liyue75/pcb/AX615D_DEMO_V1.3_SVN/AX615D_DEMO_V1_3_BOM.xlsx

项目 | AX615D_DEMO_V1_3
日期 | 2026-06-09
设计 | xieyibei@axera-tech.com
审核
序号 | 物料描述 | 数量 | 位号 | 供应商 | 供应商料号 | 加工方式 | 备注
1 | CAP CER 1uF 10% 10V 0402 X5R | 55 | C3,C6,C12,C15,C16,C29,C36,C41,C42,C53,C54,C71,C72,C79,C80,C87,C89,C91,C92,C97,C99,C106,C107,C110,C111,C112,C114,C116,C120,C121,C123,C129,C130,C135,C140,C143,C144,C146,C148,C149,C152,C153,C154,C155,C158,C159,C260,C261,C264,C269,C580,C590,C591,C640,C642 |  |  | SMT
2 | CAP CER 18pF 5% 50V 0402 C0G | 4 | C4,C7,C9,C11 |  |  | SMT
3 | CAP CER 12pF 5% 50V 0402 C0G | 2 | C5,C8 |  |  | SMT
4 | CAP CER 100nF 10% 16V 0402 X7R | 47 | C13,C14,C19,C24,C25,C30,C31,C32,C34,C43,C45,C55,C57,C68,C70,C73,C75,C78,C82,C84,C100,C101,C103,C108,C113,C119,C126,C134,C138,C161,C162,C163,C164,C165,C166,C168,C170,C194,C218,C219,C244,C252,C256,C262,C440,C567,C607 |  |  | SMT
5 | CAP CER 2.2uF 10% 6.3V 0402 X5R | 15 | C18,C21,C28,C33,C35,C167,C169,C182,C502,C503,C557,C623,C624,C628,C629 |  |  | SMT
6 | CAP CER 10uF 20% 10V 0603 X7R | 25 | C40,C44,C46,C67,C69,C74,C77,C81,C83,C85,C86,C109,C115,C131,C132,C133,C139,C160,C253,C254,C255,C263,C415,C581,C641 |  |  | SMT
7 | CAP CER 10nF 10% 50V 0402 X7R | 10 | C50,C51,C56,C58,C136,C137,C150,C151,C156,C157 |  |  | SMT
8 | CAP CER 1uF 10% 25V 0402 X7R | 8 | C59,C60,C61,C62,C63,C64,C65,C66 |  |  | SMT
9 | CAP CER 4.7uF 20% 6.3V 0402 X5R | 1 | C76 |  |  | SMT
10 | CAP CER 33pF 5% 50V 0402 C0G | 4 | C93,C94,C95,C96 |  |  | SMT
11 | CAP CER 100uF 20% 10V 1210 X5R | 1 | C98 |  |  | SMT
12 | CAP CER 22uF 20% 10V 0603 X5R | 40 | C117,C118,C122,C124,C141,C142,C177,C178,C179,C184,C185,C188,C191,C200,C202,C203,C204,C212,C214,C215,C216,C217,C225,C228,C229,C230,C242,C245,C246,C247,C248,C563,C564,C592,C594,C596,C598,C600,C602,C603 |  |  | SMT
13 | CAP CER 220nF 10% 10V 0402 X7R | 3 | C145,C147,C210 |  |  | SMT
14 | CAP CER 100nF 10% 50V 0402 X5R | 5 | C171,C172,C175,C176,C181 |  |  | SMT
15 | CAP CER 22uF 20% 25V 0805 X5R | 3 | C173,C174,C251 |  |  | SMT
16 | CAP CER 2nF 10% 50V 0402 X7R | 1 | C180 |  |  | SMT
17 | CAP CER 100pF 5% 50V 0402 C0G | 4 | C183,C192,C227,C234 |  |  | SMT
18 | CAP CER 22pF 5% 50V 0402 C0G | 1 | C201 |  |  | SMT
19 | CAP CER 220pF 10% 50V 0402 X7R | 3 | C213,C243,C605 |  |  | SMT
20 | CAP CER 22nF 10% 50V 0402 X7R | 2 | C235,C265 |  |  | SMT
21 | CAP CER 47nF 10% 50V 0402 X7R | 2 | C249,C601 |  |  | SMT
22 | CAP CER 10uF 20% 25V 0603 X5R | 2 | C266,C267 |  |  | SMT
23 | CAP CER 1uF 20% 6.3V 0201 X5R | 12 | C559,C560,C561,C613,C614,C615,C616,C617,C618,C619,C625,C626 |  |  | SMT
24 | CAP CER 1000pF 10% 2KV 1206 X7R | 1 | C562 |  |  | SMT
25 | CAP CER 10pF 5% 50V 0402 C0G | 6 | C573,C574,C575,C576,C593,C597 |  |  | SMT
26 | Schottky, Vr 30V, If 0.2A, SOD-523 | 1 | D1 | ONSemi | RB520S30T1G | SMT
27 | TVS Bidirection 5V 300W SOD-523 | 7 | D3,D4,D19,D20,D21,D22,D34 | WAYON | WS05D5-B | SMT
28 | TVS Bidirection 5V 310W SOD-323 | 8 | D5,D6,D7,D8,D9,D10,D11,D13 | WAYON | WS05DLC-B | SMT
29 | TVS 135W 5V 2.5pF SOT-143 | 2 | D12,D29 | WAYON | WS05RXLC | SMT
30 | TVS Bidirection 3.3V 320W SOD-323 | 6 | D16,D17,D35,D36,D37,D38 | WAYON | WS03DLC-B | SMT
31 | TVS Bidirection 6.5V 600W SMB | 6 | D23,D24,D25,D26,D27,D28 | WAYON | WS6.5P6SMB-B | SMT
32 | TVS Bidirection, 3000W, 15V, SMC | 1 | D30 | WAYON | WS15P30SMC-B | SMT
33 | LED 0603, Brilliant Red | 1 | D31 | EverLight | 19-217/R6C-AL1M2VY/3T | SMT
34 | Gas discharge tube, 8/20us 5KA, 90V, 5x5mm | 1 | D33 | RUILON | SMD5050-090NA | SMT
35 | Ferrite Bead, 450mA, DCR 340mohm, 600ohm at 100MHz, 0402 | 2 | FB3,FB4 | Sunlord | PZ1005U601-R45TF | SMT
36 | Ferrite Bead, 2A, DCR 80mohm, 220ohm at 100MHz, 01206 | 10 | FB6,FB7,FB8,FB12,FB13,FB14,FB15,FB20,FB21,FB22 | Sunlord | PZ3216U221-2R0TF | SMT
37 | Ferrite Bead, 600mA, DCR 180mohm, 220ohm at 100MHz, 0402 | 2 | FB9,FB10 | Sunlord | PZ1005E221-R60TF | SMT
38 | Ferrite Bead, 3A, DCR 30mohm, 30ohm at 100MHz, 0603 | 4 | FB16,FB17,FB18,FB19 | Sunlord | PZ1608D300-3R0TF | SMT
39 | WAFER, 1.25mm, 5pin, 1.0A | 1 | J1 | TXGA | FWF12505-S05S24W5M | SMT
40 | Screw Header 2x1 Pin, Pitch 3.81mm | 5 | J2,J16,J19,J20,J32 | DEGSON | DG380-3.81-02P-14 | DIP
41 | TF Card Socket TF-01A | 1 | J3 | HRO | TF-01A | SMT
42 | Header 3P Pitch 2.54mm | 4 | J5,J8,J23,J29 |  |  | DIP
43 | Micro USB Female 5P SMT | 2 | J6,J21 | Dongguan VAST | C-103012662-00 | SMT
44 | RJ45 DIP TYPE WITH 2 LEDs | 1 | J7 | Dongguan VAST | C-120010911-00 | DIP
45 | FFC/FPC Connector,0.5mm,V-Flip,4.05mm,50Circuits | 3 | J9,J10,J11 | MOLEX | 5019515010 | SMT
46 | FPC , 50P, Pitch 0.5mm, Bottom Contact | 2 | J12,J30 | GYUEDA | FPC50_T1T1_2020_A | SMT
47 | FFC/FPC Connector,0.5mm,V-Flip,4.05mm,40Circuits | 2 | J13,J25 | MOLEX | 501951-4010 | SMT
48 | WAFER, 1.25mm, 2pin, 1.0A | 2 | J14,J15 | TXGA | FWF12505-S02S24W5M | SMT
49 | 3.5mm SMD Headphone Holder | 2 | J17,J18 | XKB | PJ-327A0-SMT | SMT
50 | Header, 2P, Pitch 2.54mm, XH2.54-2P | 1 | J24 |  | XH2.54-2P | DIP
51 | DC JACK, 5.5mm, 30V, 3A ,hole 2.0 | 1 | J26 | XUNPU | DC-005-A200 | DIP
52 | Header 8P Pitch 2.54mm | 1 | J28 |  |  | DIP
53 | IND WIRE 1uH 20% Irms=8.5A Isat=10A 14mOhm | 1 | L3 | Sunlord | MWSA0503S-1R0MT | SMT
54 | IND WIRE 2.2uH 20% Irms=1.7A,Isat=2.15A 142mohm, 2.0x1.6x1.0mm | 6 | L4,L5,L6,L10,L11,L14 | Sunlord | WPN201610H2R2MT | SMT
55 | IND 0.47uH 20% 3.7A 38mOhm | 4 | L8,L12,L16,L17 | Sunlord | WPN252010HR47MT | SMT
56 | IND Wire Wound 2.2uH 20% 2.4A 80mOhm | 1 | L13 | Sunlord | WPN252010U2R2MT | SMT
57 | IND WIRE 1.0uH 20% Irms=6.0A Isat=7A 27mOhm | 1 | L18 | Sunlord | MWSA0402S-1R0MT | SMT
58 | PMOS, Vds -20V, Id -4.3A, SOT23-3 | 2 | Q1,Q6 | Will | WPM2341-3/TR | SMT
59 | NPN Transistor, Ic 200mA, Vce 40V,SOT23-3 | 2 | Q2,Q7 | NEXPERIA | PMBT3904 | SMT
60 | NMOS, Vds 20V, Id 0.90A, SOT-23 | 2 | Q3,Q5 | Will | WNM2020-3/TR | SMT
61 | PTC 16V 5A 2.6W DIP | 1 | RV1 | WAYON | LP16-500F | DIP
62 | RES 0R 1% 0402 | 201 | R1,R2,R4,R19,R27,R35,R36,R40,R60,R62,R63,R64,R66,R67,R68,R73,R95,R97,R98,R105,R106,R114,R115,R116,R117,R121,R122,R127,R131,R132,R137,R138,R141,R143,R144,R147,R148,R151,R152,R155,R156,R159,R160,R163,R164,R167,R168,R169,R170,R171,R172,R176,R177,R179,R180,R181,R182,R183,R184,R185,R188,R192,R194,R197,R198,R199,R200,R201,R202,R209,R210,R212,R214,R215,R217,R219,R221,R223,R224,R225,R227,R228,R229,R230,R232,R234,R237,R239,R240,R241,R242,R245,R246,R247,R251,R252,R254,R255,R256,R267,R271,R273,R274,R278,R279,R280,R281,R283,R285,R286,R287,R291,R293,R296,R297,R298,R299,R300,R301,R303,R304,R305,R306,R309,R310,R311,R335,R341,R342,R432,R464,R465,R466,R467,R468,R469,R470,R471,R475,R476,R483,R484,R485,R486,R487,R489,R669,R671,R693,R695,R700,R702,R704,R706,R709,R711,R717,R724,R729,R733,R738,R748,R755,R756,R766,R767,R768,R769,R770,R775,R780,R782,R784,R807,R808,R810,R812,R822,R823,R825,R826,R828,R831,R832,R834,R835,R844,R845,R846,R847,R848,R849,R850,R851,R852,R853,R854,R855,R857,R858,R859 |  |  | SMT
63 | RES 1.4K 1% 0402 | 1 | R5 |  |  | SMT
64 | RES 47K 1% 0402 | 8 | R7,R8,R10,R11,R30,R289,R346,R690 |  |  | SMT
65 | RES 100R 1% 0402 | 3 | R9,R779,R836 |  |  | SMT
66 | RES 200R 1% 0402 | 1 | R14 |  |  | SMT
67 | RES 620R 1% 0402 | 1 | R16 |  |  | SMT
68 | RES 1M 1% 0402 | 1 | R18 |  |  | SMT
69 | RES 1.5K 1% 0402 | 6 | R21,R22,R23,R24,R672,R673 |  |  | SMT
70 | RES 1K 1% 0402 | 7 | R28,R33,R34,R100,R350,R759,R806 |  |  | SMT
71 | RES 4.7K 1% 0402 | 31 | R29,R31,R32,R41,R59,R69,R70,R71,R101,R203,R204,R205,R206,R207,R208,R250,R321,R322,R327,R328,R337,R338,R339,R344,R349,R353,R424,R426,R430,R758,R833 |  |  | SMT
72 | RES 10K 1% 0402 | 29 | R43,R93,R94,R268,R269,R307,R308,R312,R313,R314,R343,R345,R352,R385,R410,R421,R453,R454,R455,R456,R457,R458,R459,R460,R461,R462,R607,R663,R698 |  |  | SMT
73 | RES 100K 1% 0402 | 25 | R99,R288,R290,R295,R347,R362,R363,R364,R365,R383,R399,R400,R402,R403,R415,R661,R677,R786,R787,R789,R790,R797,R799,R837,R838 |  |  | SMT
74 | RES 470R 1% 0402 | 4 | R102,R109,R112,R778 |  |  | SMT
75 | RES 2.2R 1% 0402 | 4 | R104,R107,R108,R110 |  |  | SMT
76 | RES 0R 1% 1206 | 1 | R113 |  |  | SMT
77 | RES 33R 1% 0402 | 1 | R248 |  |  | SMT
78 | RES 1.1K 1% 0402 | 8 | R257,R258,R259,R260,R263,R264,R265,R266 |  |  | SMT
79 | RES 0R 1% 0603 | 5 | R275,R282,R355,R393,R680 |  |  | SMT
80 | RES 20K 1% 0402 | 6 | R315,R316,R317,R318,R388,R412 |  |  | SMT
81 | RES 2K 1% 0402 | 5 | R319,R323,R325,R329,R428 |  |  | SMT
82 | RES 30K 1% 0402 | 7 | R320,R324,R326,R330,R382,R407,R839 |  |  | SMT
83 | RES 5mOhm 1% 2W 2512 | 8 | R348,R359,R360,R372,R380,R395,R396,R408 | YAGEO | PA2512FKF7W0R005E | SMT
84 | RES 40.2K 1% 0402 | 4 | R351,R381,R414,R804 |  |  | SMT
85 | RES 5.49K 1% 0402 | 1 | R354 |  |  | SMT
86 | RES 200K 1% 0402 | 3 | R361,R397,R792 |  |  | SMT
87 | RES 22.1K 1% 0402 | 2 | R366,R404 |  |  | SMT
88 | RES 80.6K 1% 0402 | 5 | R374,R378,R387,R416,R805 |  |  | SMT
89 | RES 150K 1% 0402 | 2 | R375,R423 |  |  | SMT
90 | RES 240K 1% 0402 | 2 | R384,R409 |  |  | SMT
91 | RES 75K 1% 0402 | 1 | R425 |  |  | SMT
92 | RES 511R 1% 0402 | 1 | R429 |  |  | SMT
93 | RES 0R 1% 0805 | 3 | R473,R772,R781 |  |  | SMT
94 | RES 75R 1% 1206 | 2 | R490,R668 |  |  | SMT
95 | RES 22R 1% 0402 | 2 | R776,R777 |  |  | SMT
96 | RES 300K 1% 0402 | 1 | R788 |  |  | SMT
97 | RES 82K 1% 0402 | 2 | R791,R793 |  |  | SMT
98 | Push Button 4PIN 4.5x4.5x3.8mm SMT | 3 | SW2,SW3,SW4 | HRO | K2-1109SP | SMT
99 | Switch, 2 Way, Pitch 1.27mm, SMT | 5 | S1,S2,S3,S7,S12 | HRO | EP-02KS | SMT
100 | Switch, 4 Way, Pitch 1.27mm, SMT | 4 | S4,S9,S10,S11 | HRO | EP-04KS | SMT
101 | Switch, 8 Way, Pitch 1.27mm, SMT | 5 | S5,S6,S8,S13,S14 | HRO | EP-08KS | SMT
102 | Transformer 10/100 Base-T,Surface Mount Type,H1601CG, 0~70??, | 1 | T1 | Mentech | H1601CG | SMT
103 | AX615D | 1 | U1 | AXERA | AX615D | SMT
104 | Lithium Rechargeable Battery, 6.8x2.1mm, 3V, 5.5mAh | 1 | U2 | SII | MS621FE-FL11E | Hand
105 | IC low power RTC chip with I2C, 1.3~5.5V, MSOP8 3x3mm H1.1mm | 1 | U3 | AnalogTek | AT8563S | SMT
106 | IC 2-Bit Bidirectional Voltage-Level Translator SOT23_8 2.91x1.6mm H1.25mm | 2 | U4,U23 | SGMICRO | SGM4553YN8G/TR | SMT
107 | IC SPI NOR Flash 128Mb 3.3V WSON8 | 1 | U6 | Winbond | W25Q128JVEIQ | SMT
108 | IC EMMC 8GB 2.7~3.6V 5nS SMD BGA153 | 1 | U7 | Samsung | KLM8G1GETF-B041 | SMT
109 | IC Power Switch, 2.5~5.5V, 2A, SOT23-6 | 1 | U8 | Silergy | SY6287CABC | SMT
110 | Three-Channel High-Speed MIPI Switch,2.5GHz | 2 | U9,U10 | WILL | WAS4642Q-24/TR | SMT
111 | MEMS microphone Analog output,1.6V~3.6V,Sensitvity -32dBv | 4 | U11,U12,U19,U20 | Will Semi | WMM7037ATTS7 | SMT
112 | MEMS microphone, PDM digital output,1.62~3.6V | 1 | U13 | MEMSensing | WMM7035DBUJ0-5/TR | SMT
113 | Class-D Audio Power Amplifier 3W | 1 | U14 | SGMICRO | SGM2820YMS8G/TR | SMT
114 | Stereo Audio ADC,101 dB SNR,24-bit, 8 to 96 kHz sampling frequency | 1 | U15 | Everest | ES7243L | SMT
115 | IC LDO 500mA, Vin 2.5~5.5V, Vout 1.8V, SOT23-5 | 1 | U16 | Will Semi | WL2803E18-5/TR | SMT
116 | Stereo Audio DAC,110 dB SNR,24-bit, 8 to 96 kHz sampling frequency,QFN20 | 1 | U17 | Everest | ES8156 | SMT
117 | LDO 500mA, Vin 2.5~5.5V, Vout 3.3V, SOT23-5 | 2 | U18,U37 | Will Semi | WL2803E33-5/TR | SMT
118 | Stereo Audio Power Amplifier 2.6W SGM4865 | 1 | U21 | SGMICRO | SGM4865YTQE16G/TR | SMT
119 | IC USB to UART, 2.97~5.5V, IO 1.62~3.63V, DFN-12 3x3mm 0.8mm | 1 | U22 | FTDI | FT234XD-R | SMT
120 | IC Buck 6A, 4~28V, 800KHz, QFN-12, 3x3mm, H=0.75mm | 1 | U24 | Silergy | SY8366AQQC | SMT
121 | IC BUCK, 1.5A, 2.6-7V, 2MHZ, SOT23_5, 2.95x1.7mm, H=1.25mm | 4 | U25,U26,U28,U30 | ETA | ETA3485S2F | SMT
122 | IC BUCK, 1A, 2.5-5.5V, 1.5MHZ, SOT23_5, 2.96x1.6mm, H=1.2mm | 2 | U32,U33 | Silergy | SY8088IAAC | SMT
123 | IC BUCK, COT,3A, 2.5-5.5V, 2MHZ, SOT23_5,2.92x1.6mm,H=1.15mm | 1 | U35 | ETA | ETA3448S2F | SMT
124 | IC Buck,600mA,1.8~5.5V,3.5MHZ, WLCSP-0.9X1.3-6B-A, 0.9x1.3mm, H=0.545mm | 2 | U41,U42 | SGMICRO | SGM61006XG/TR | SMT
125 | IC Buck,COT, 4A, 2.5~5.5V, Force PWM Mode, QFN-12,3x2mm,H=0.55mm | 1 | U43 | ETA | ETA3147WFQ7M | SMT
126 | IC AUDIO AMP, I2S/TDM input, 10.25V BOOST Digital Smart K PA Converter | 1 | U44 | AWINIC | AW88261FCR | SMT
127 | Crystal 32.768kHz, +-20ppm, -40~85C, 12.5pF, 3215 | 2 | X1,X3 | TXC | 9H03200031 | SMT
128 | Crystal 24MHz, 10ppm, -40~85C, 8pF, 2016 | 1 | X2 | TXC | 8Y24000042 | SMT
