liyue75/pcb/AX615D_DEMO_V1.3_SVN/AX615_AVL_V1.1.xlsx

Sheet: 质量声明
SecondSource AVL质量声明：
由于用到验证的器件（包括但不限于：Flash、Sensor、DDR等）数量有限以及验证时间受限，仅能保证AVL中提到的器件型号在爱芯对应芯片平台上做过基本功能的适配，并不能确保该器件在批量量产中发生的质量问题。器件本身的一致性和质量问题请同器件厂家沟通。 爱芯元智半导体股份有限公司

Sheet: 修订记录
日期DATE | 文档版本号 | 修改记录Revised Description
2025-10-29 | V1.0 | Initial
2026-09-30 | V1.1 | Add DDR list for AX615E

Sheet: FLASH
类型 | 厂家物料编码 | 厂家 | 工作电压 | 容量 | 擦写寿命 | 温度等级 | 测试温度
NAND | W25N02KVZEIR | WINBOND | 3.3V | 2Gbit | 6w次 | (-40~85℃) | (-40~70℃)
NAND | GD5F1GM7UEYIGY | GIGADEVICE | 3.3V | 1Gbit | 5w次 | (-40~85℃) | (-40~70℃)
NAND | F35SQA001G-WWT | foresee | 3.3V | 1Gbit | 10W次 | (-40~85℃) | (-40~70℃)
NAND | FM25LS01 | fmsh | 1.8V | 1Gbit | 10W次 | (-40~85℃) | (-40~70℃)
NOR | W25Q128JVEIQ | WINBOND | 3.3V | 128Mbit | 10w次 | (-40~125℃) | (-40~70℃)

Sheet: DDR
 | Platform Info/平台信息 |  |  | Device Info/器件信息
序号 | 平台 | 测试频率 | 测试温度 | 厂家物料编码 | 厂家 | 类型 | 容量 | 频率 | 温度等级
1 | AX615E | 1866Mbps | (-40~70℃) | W632GU6RB11k | Winbond | DDR3L | 2Gb | 1866Mbps | –40°C to +105°C

Sheet: DCDC
电源 | P/N | Vendor | Current | Input Voltage | Reference Voltage | Switdching Frequency | Operating Junction Temp | Package | 备注
VDDCORE | ETA3448S2F | ETA | 3A | 2.5V to 5.5V | 0.6V | 2MHz | -40°C to +85°C | SOT23-5
 | ETA3147WFQ7M | ETA | 4A | 2.5V to 5.5V | 0.6V | 1MHz | -40°C to +85°C | QFN2x3-12
AON_VDDCORE | ETA3485S2F | ETA | 1.5A | 2.6V to 7V | 0.6V | 2MHz | -40°C to +85°C | SOT23-5
 | SGM61006XG/TR | SGM | 0.6A | 4.5V to 17V | 0.6V | 3.5MHz | -40°C to +85°C | WLCSP-0.9×1.3-6B-A
