liyue75/pcb/SENSOR_SC438HAI_V1_0_Assembly.pdf

# ART FILM - ASSEMBLY_TOP

5V

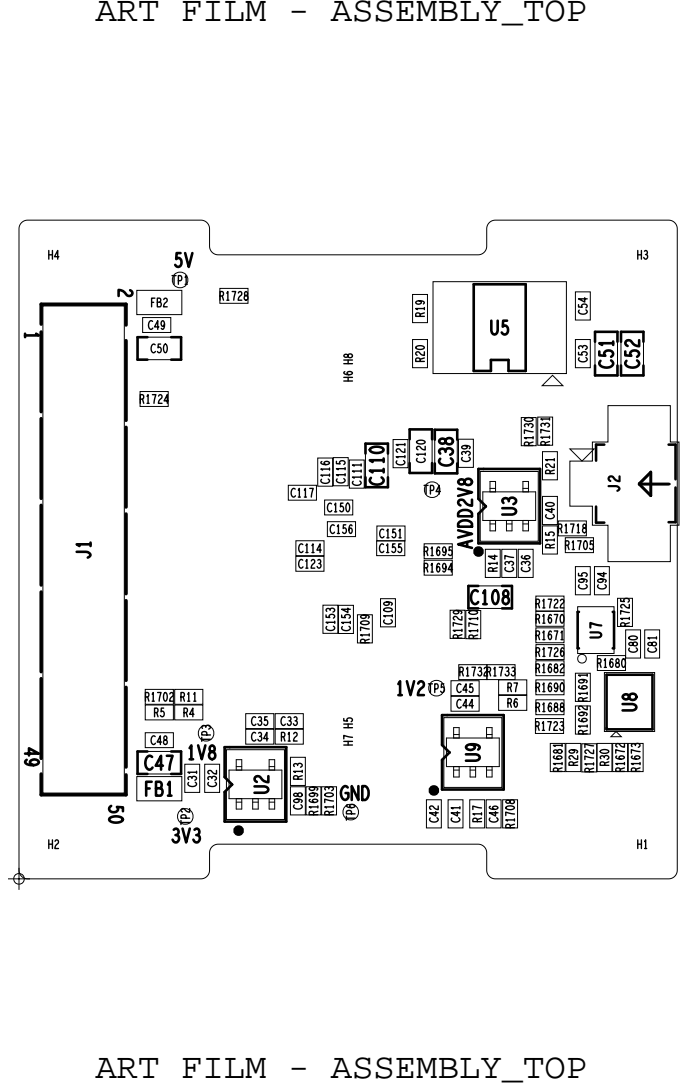
[picture p1: page 1]

# ART FILM - ASSEMBLY_BOT

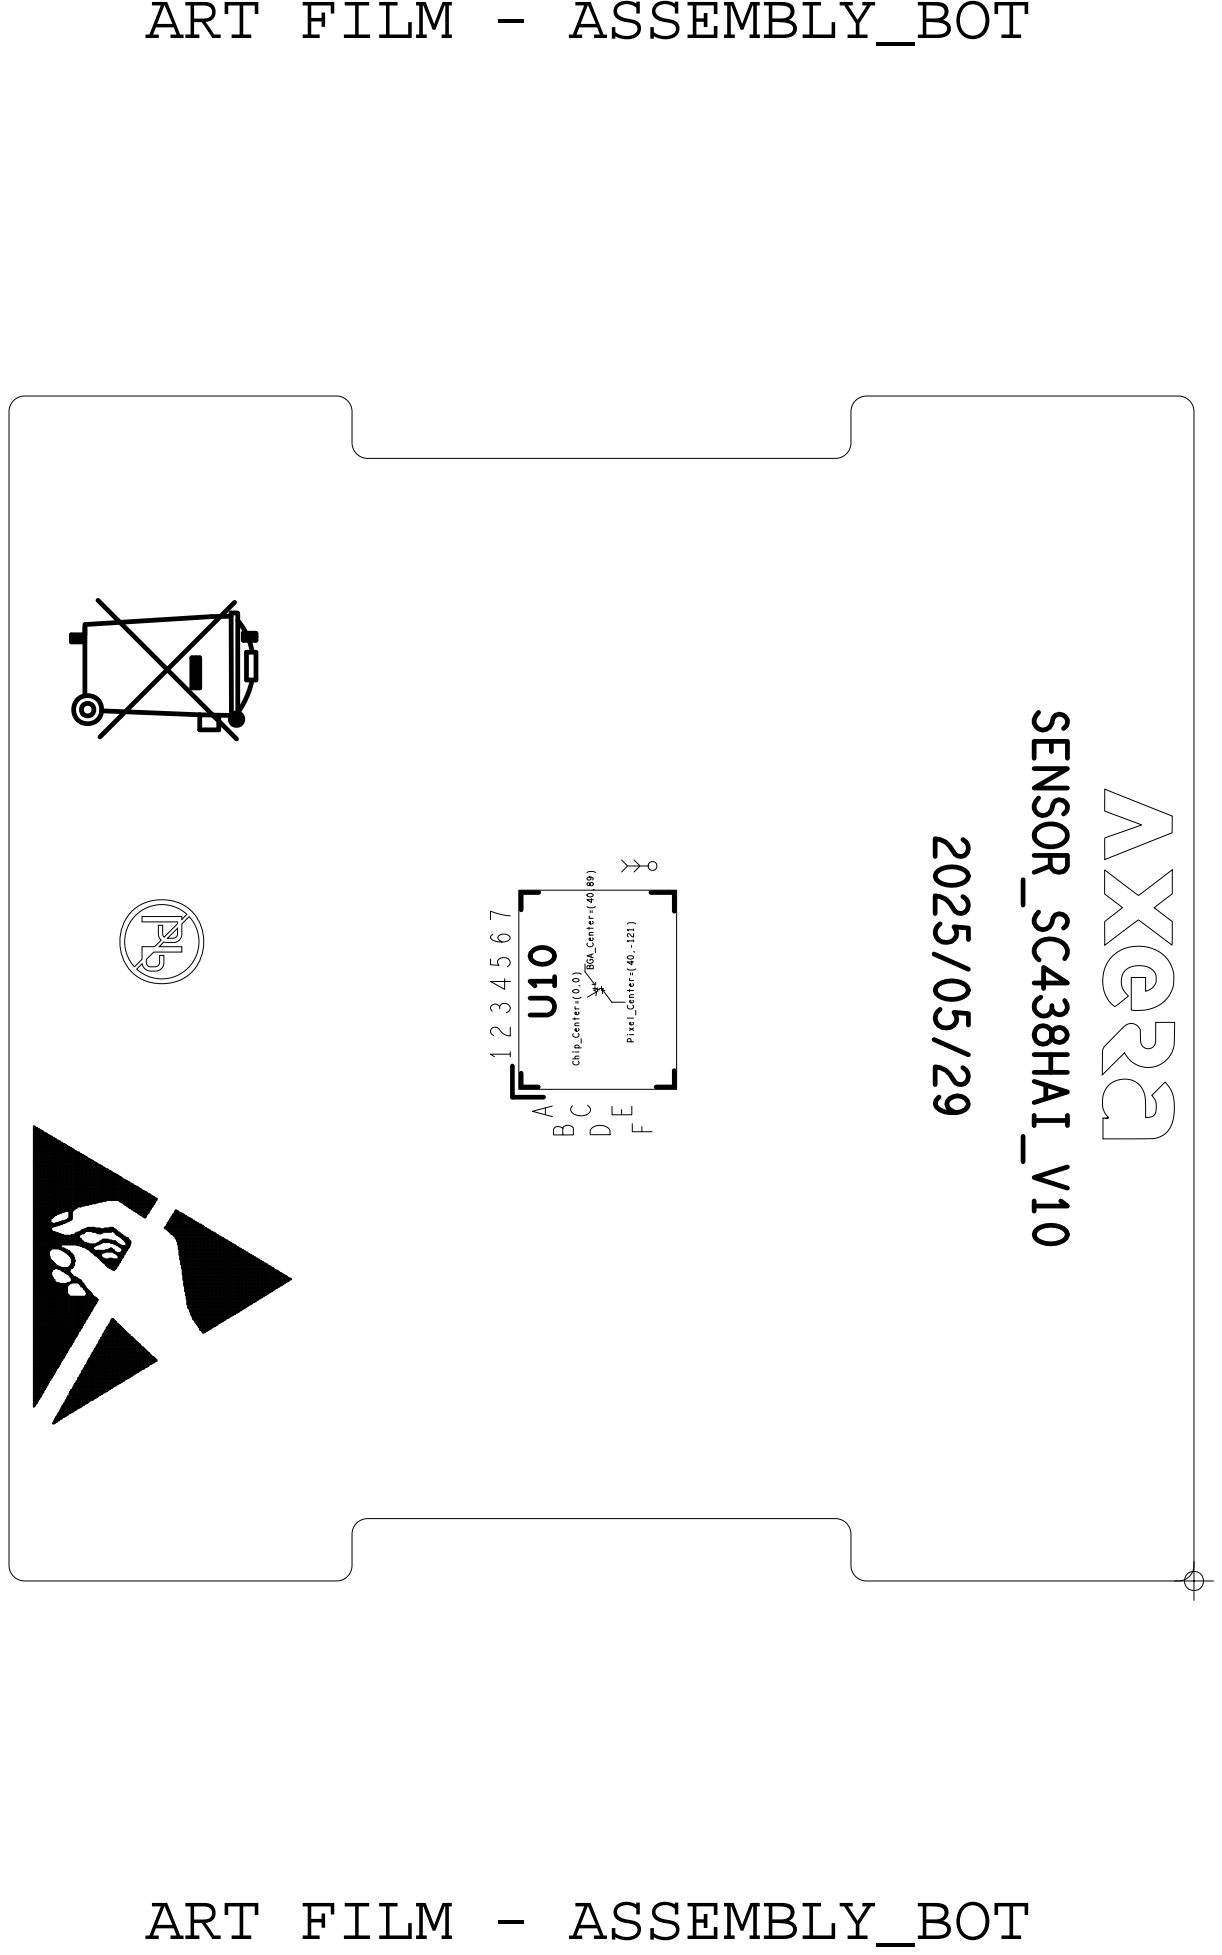
[picture p2: page 2]
ART FILM - ASSEMBLY_BOT; BGA_Center=(40,89); Chip_Center=(0,0) B; Pixel_Center=(40,-121); SENSOR_SC438HAI_V10
