liyue75/pcb/SENSOR_SC438HAI_V1_0.pdf

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
# SENSOR_SC438HAI VER 1.0

# P01.Revision History P02.Sensor P03.Power P04.Cononector

# P00.Cover

# P05.IR-CUT

# Create Project

# Date Author

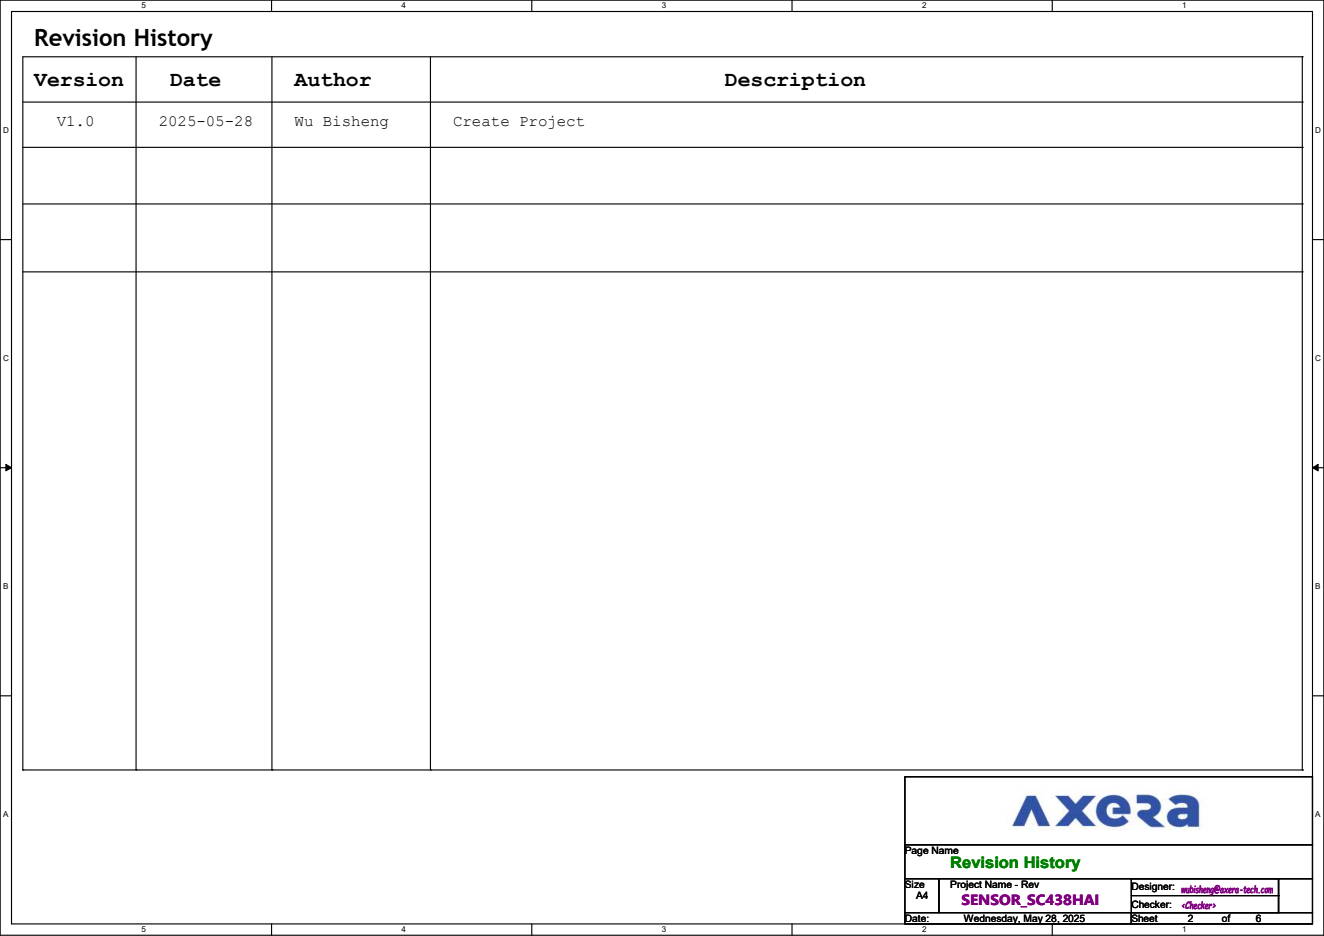
[picture p3: page 2]
Revision History; Description; Version; Wu Bisheng; Page Name; Size; Project Name - Rev; Date:; Sheet; Designer:; SENSOR_SC438HAI; Checker:; Wednesday, May 28, 2025

wubisheng@axera-tech.com
<Checker>

# 100nF/16V C156

# 4.7uF/6.3V C123

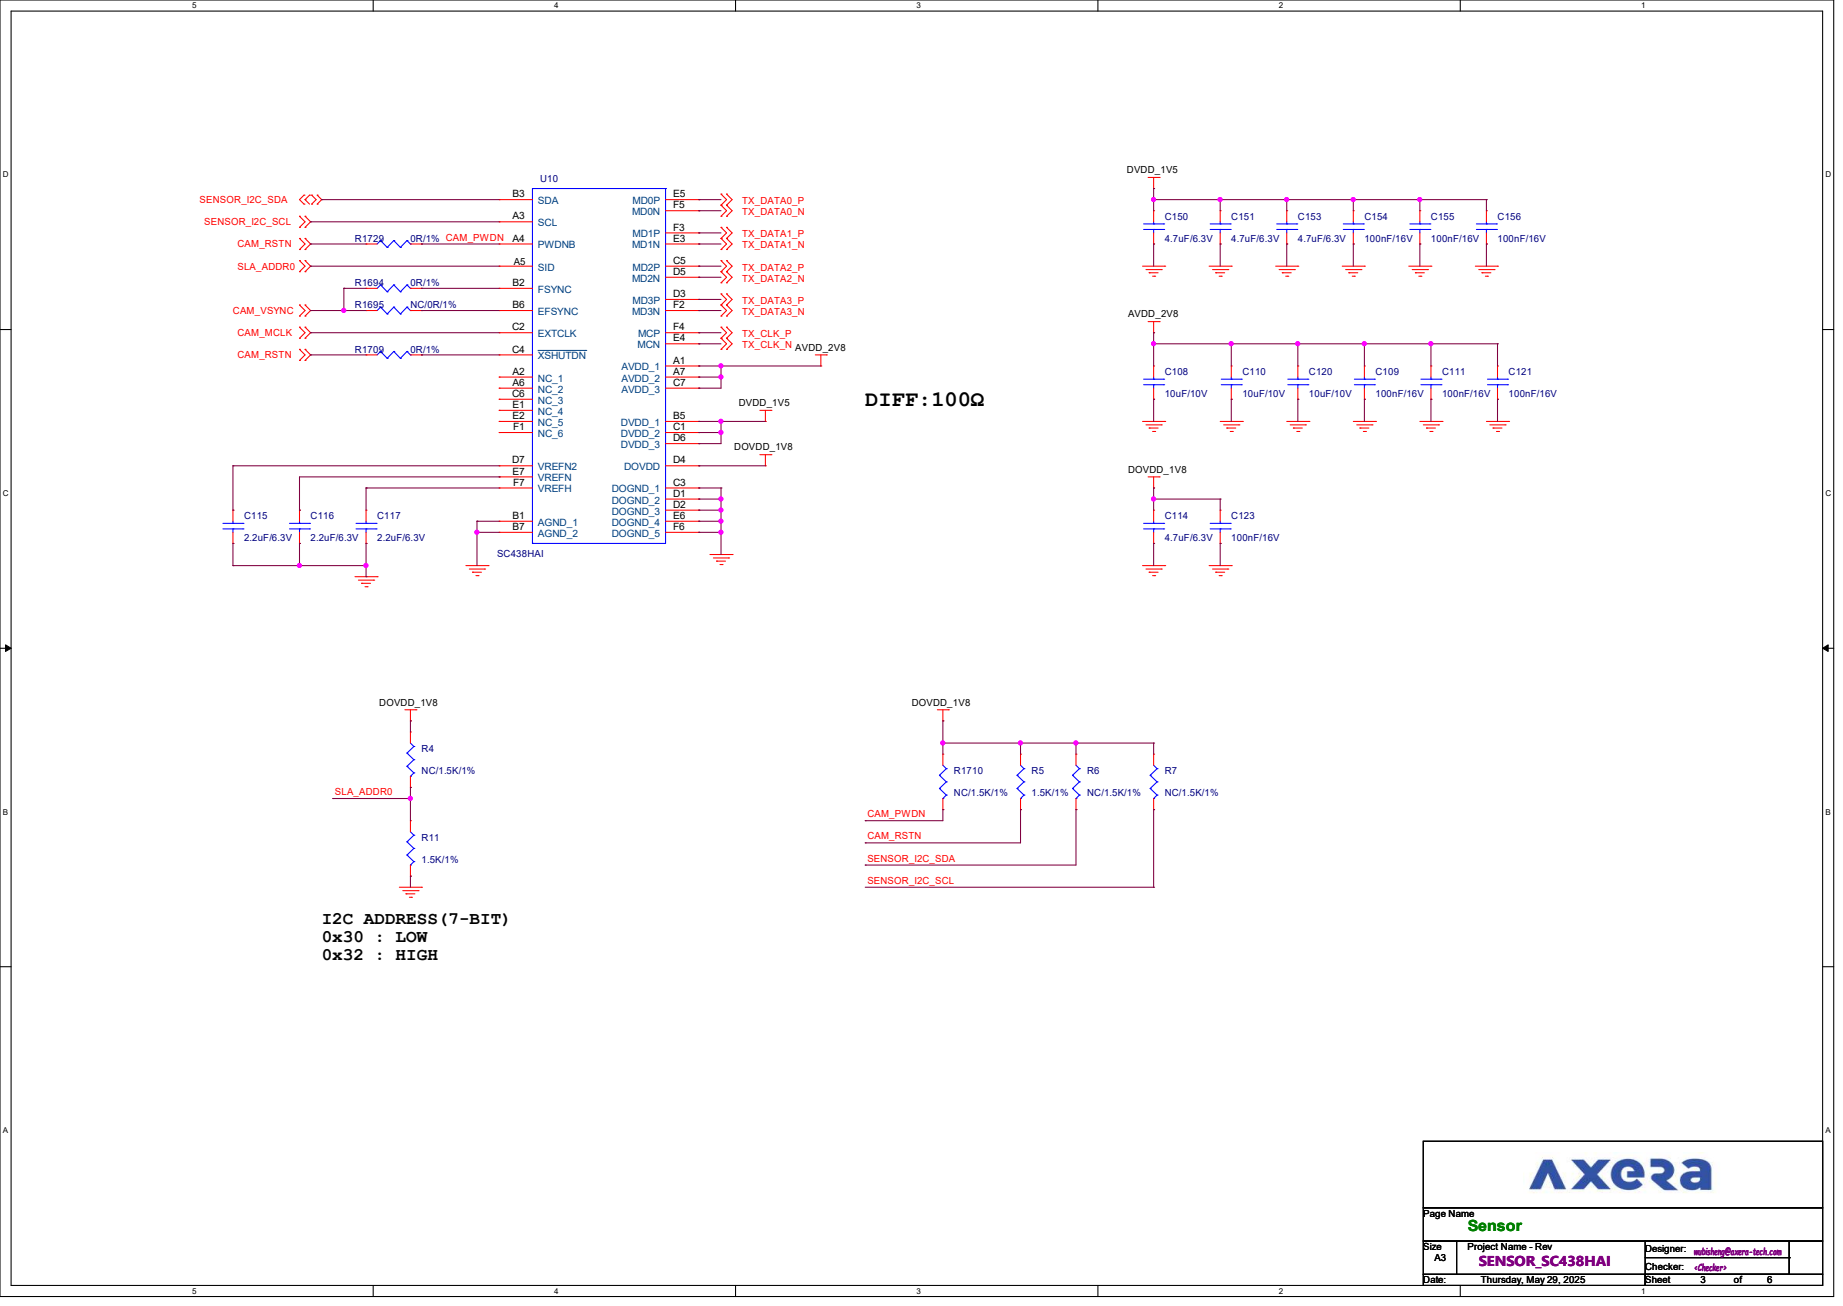
[picture p4: page 3]

DVDD_3V3 | DOVDD_1V8

R12

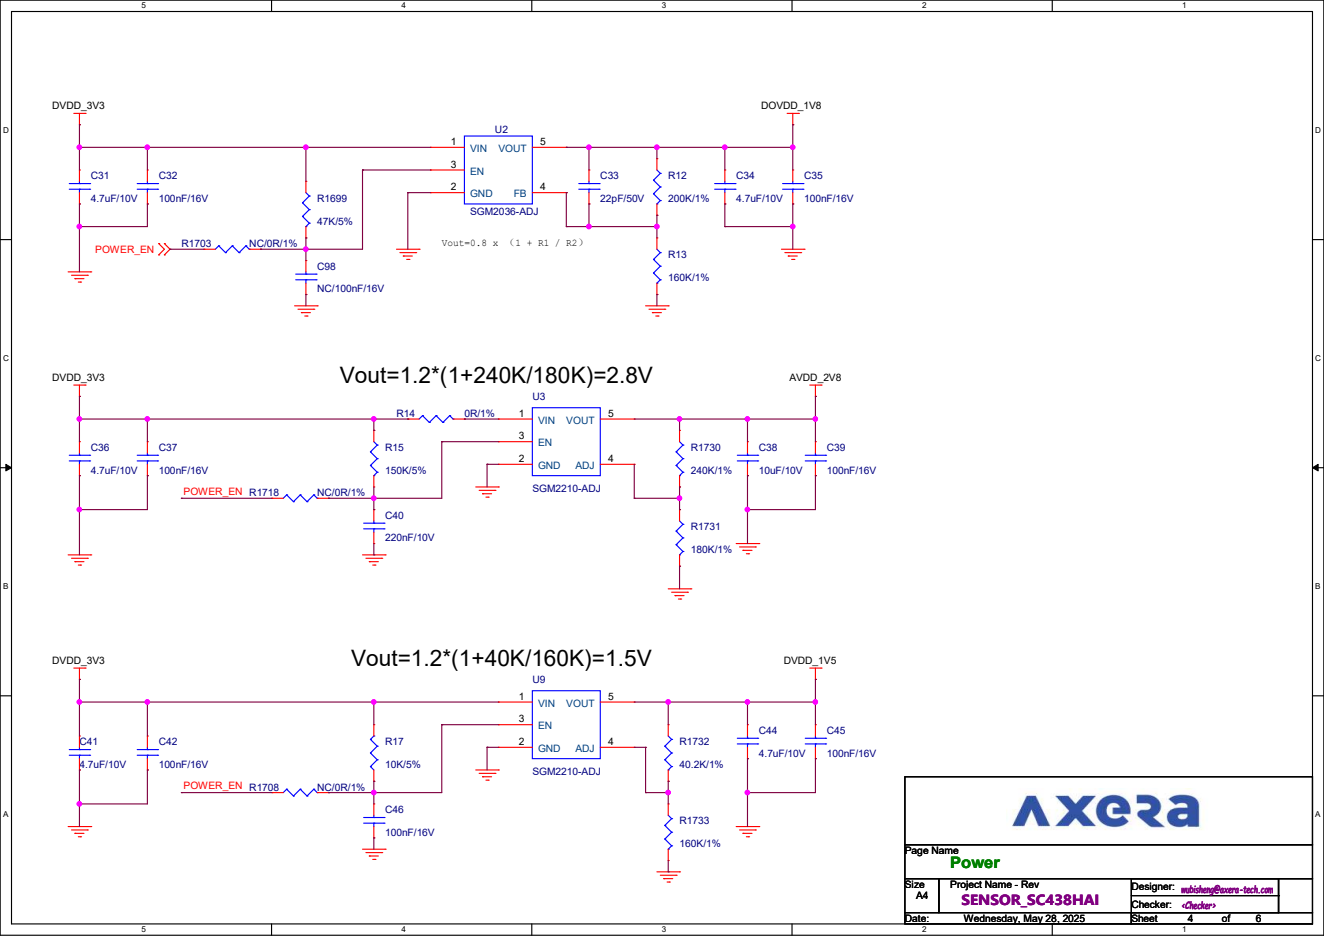
[picture p5: page 4]

wubisheng@axera-tech.com

Contact Side J1 | VSS BO¹ | VSS BO²

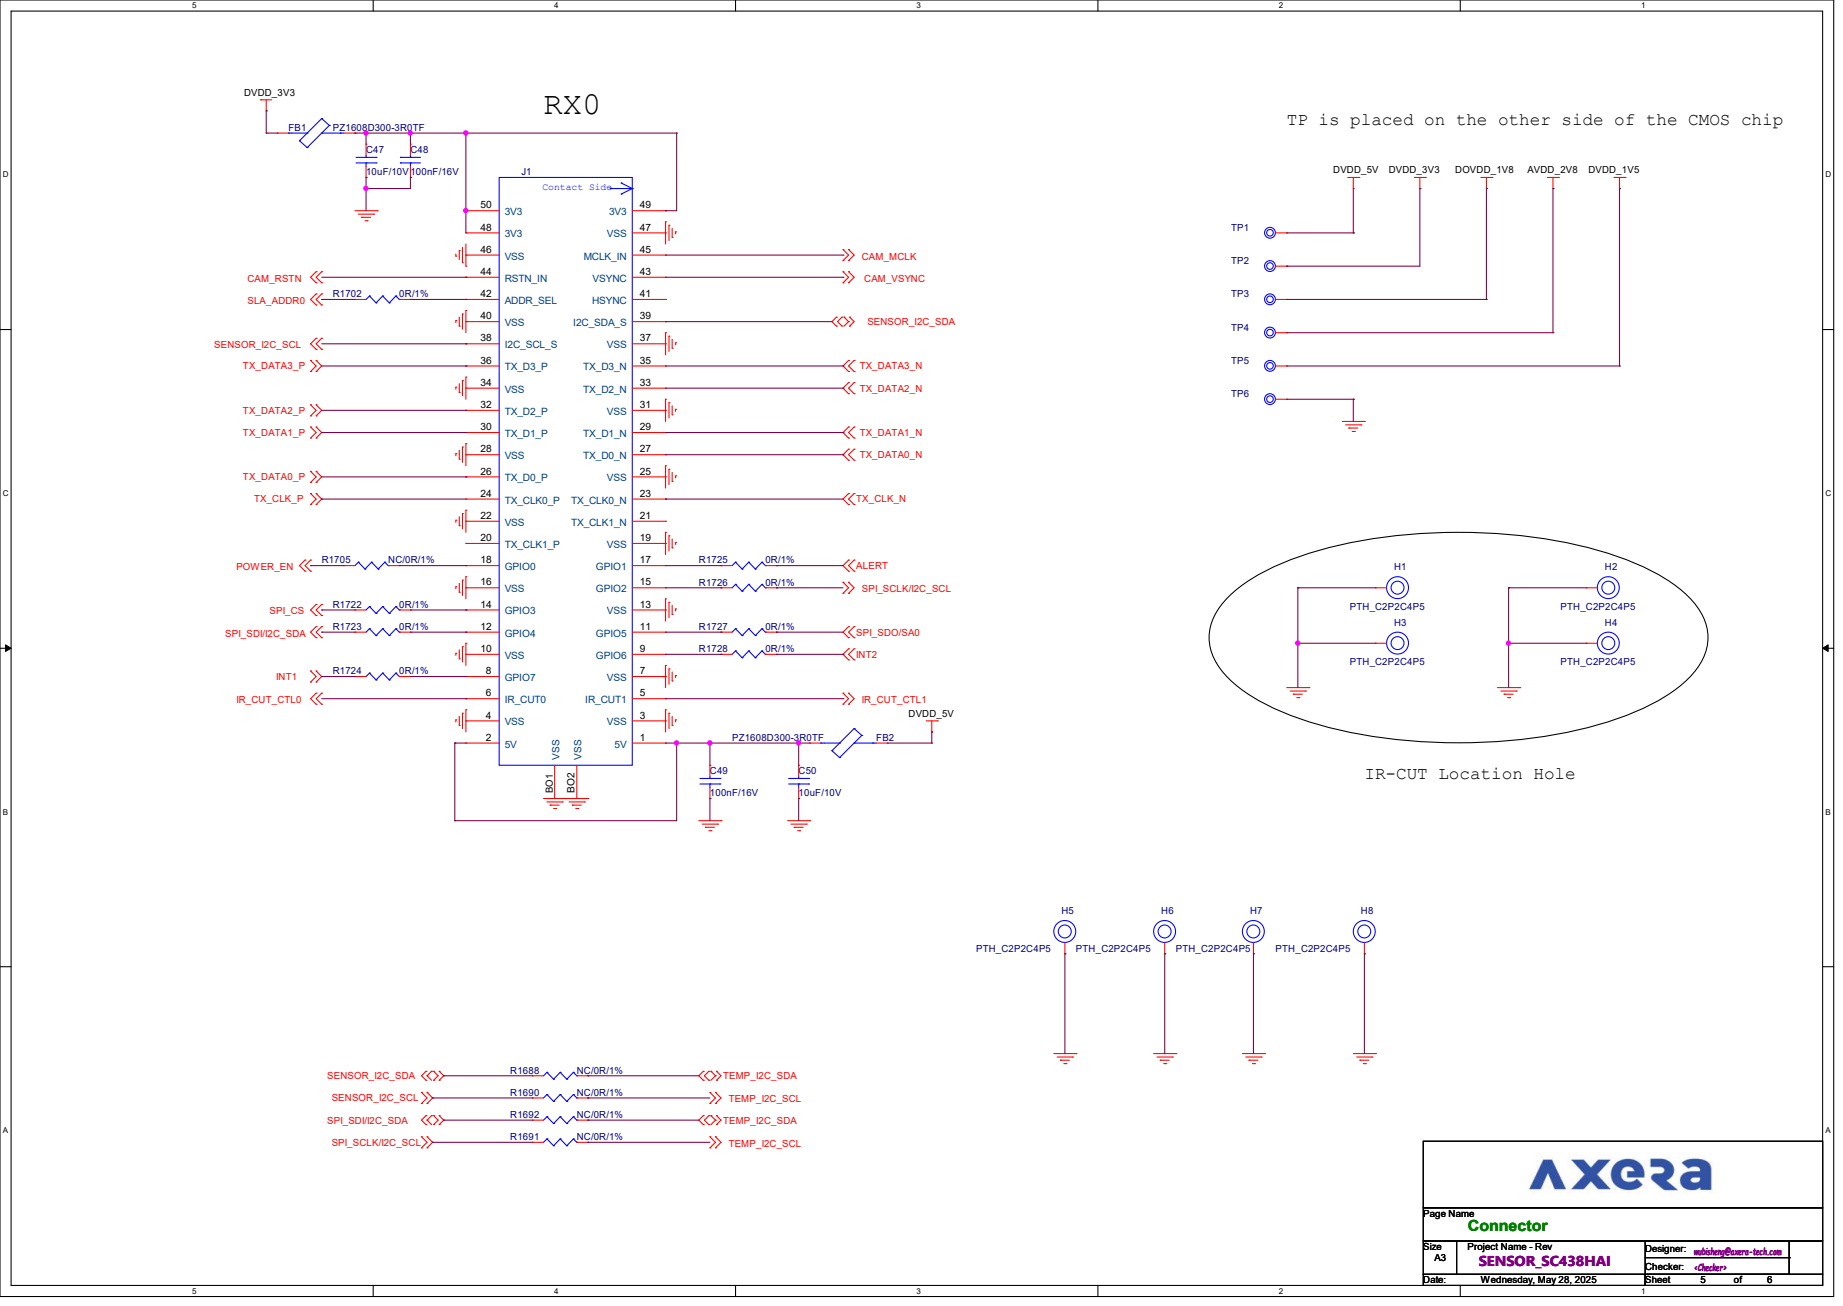
[picture p6: page 5]

IR-CUT Location Hole

# CS=1,I2C mode

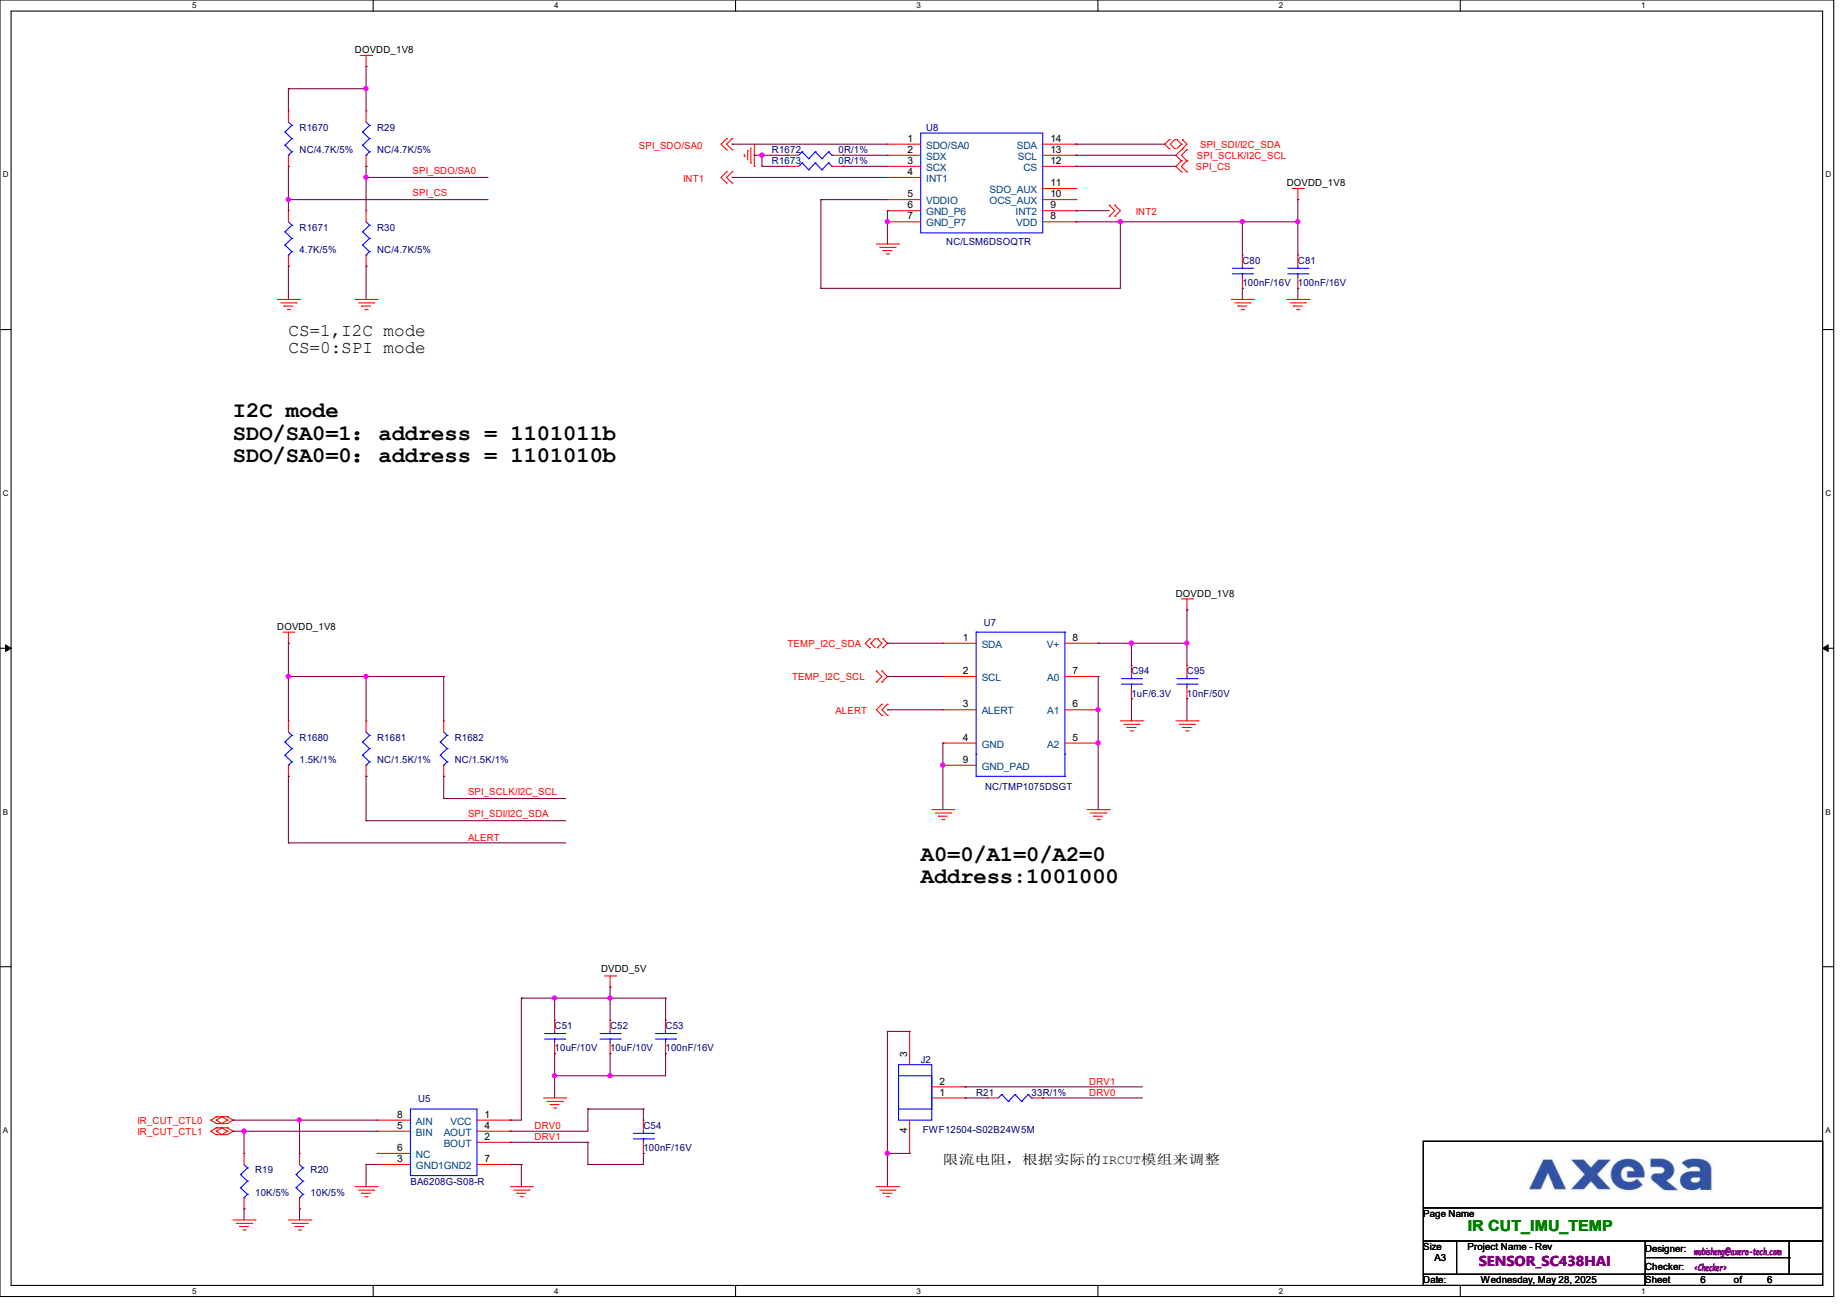
[picture p7: page 6]
