liyue75/pcb/AX615D_DEMO_V1.3_SVN/AX615D_DEMO_V1_3.pdf

A

X

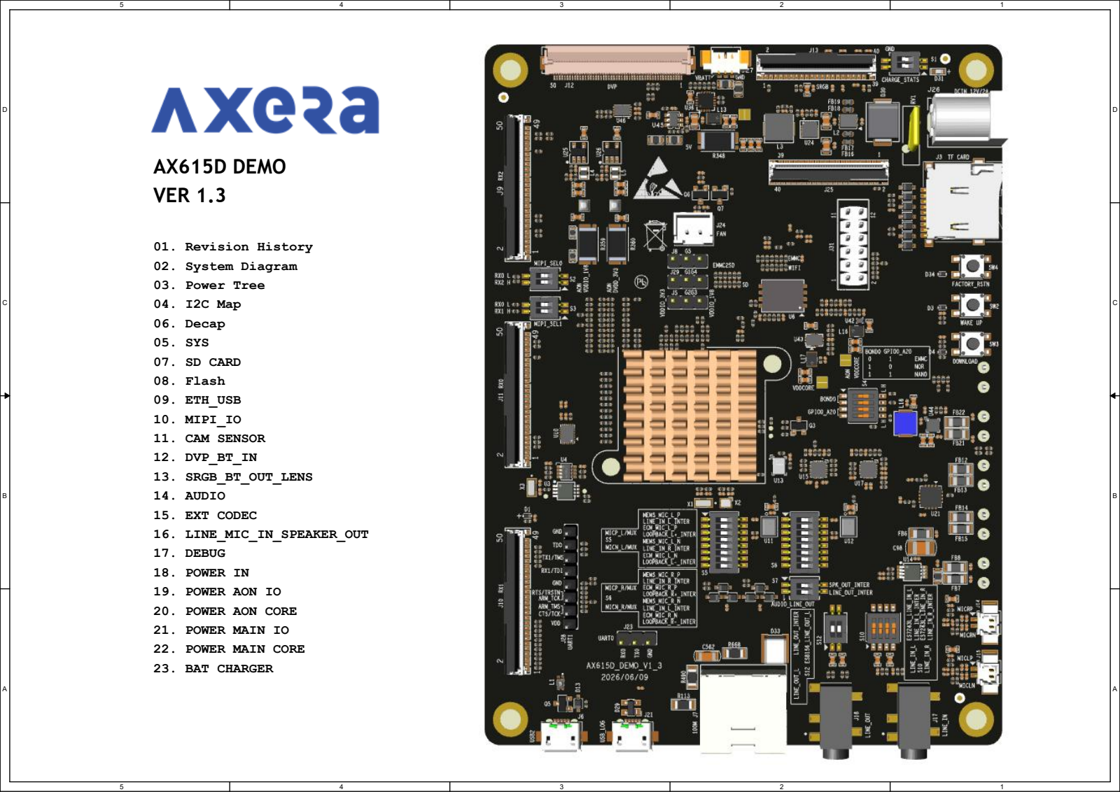
[picture p8: page 1]

55

44

33

22

11

D

D

C | C
B | B

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
# B_B

# T_O

U

# T_L

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
# R_O

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
# H_U

S

B

0

7

S

D

C

# ARD

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
# P_B

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
# HAR

G

E

R

Version | Date | Author | Description
V1.0 | 2025-05-20 | xie yibei | Create Project

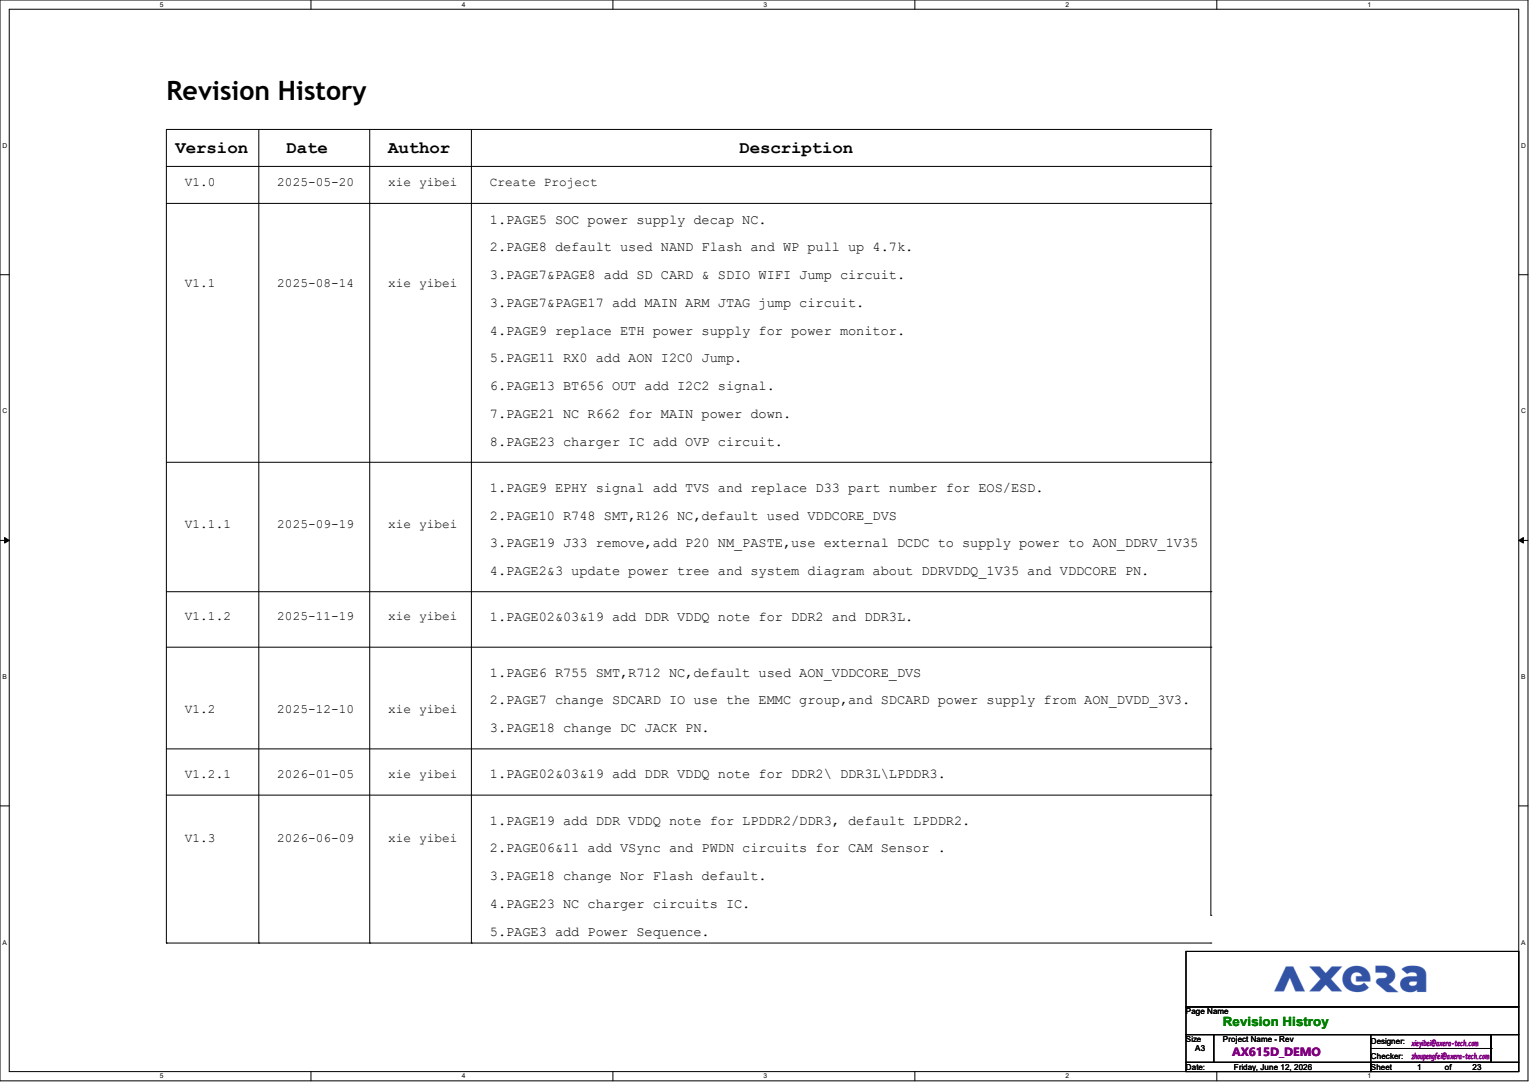
[picture p9: page 2]
Revision History; Page Name; Size; Project Name - Rev; Date:; Sheet; Designer:; Checker:; _DEMO; Revision Histroy; Friday, June 12, 2026

V1.1 | 2025-08-14 | xie yibei | 1.PAGE5 SOC power supply decap NC. 2.PAGE8 default used NAND Flash and WP pull up 4.7k. 3.PAGE7&PAGE8 add SD CARD & SDIO WIFI Jump circuit. 3.PAGE7&PAGE17 add MAIN ARM JTAG jump circuit. 4.PAGE9 replace ETH power supply for power monitor. 5.PAGE11 RX0 add AON I2C0 Jump. 6.PAGE13 BT656 OUT add I2C2 signal. 7.PAGE21 NC R662 for MAIN power down. 8.PAGE23 charger IC add OVP circuit.

V1.1.1 | 2025-09-19 | xie yibei | 1.PAGE9 EPHY signal add TVS and replace D33 part number for EOS/ESD. 2.PAGE10 R748 SMT,R126 NC,default used VDDCORE_DVS 3.PAGE19 J33 remove,add P20 NM_PASTE,use external DCDC to supply power to AON_DDRV_1V35 4.PAGE2&3 update power tree and system diagram about DDRVDDQ_1V35 and VDDCORE PN.

V1.1.2 | 2025-11-19 | xie yibei | 1.PAGE02&03&19 add DDR VDDQ note for DDR2 and DDR3L.

V1.2 | 2025-12-10 | xie yibei | 1.PAGE6 R755 SMT,R712 NC,default used AON_VDDCORE_DVS 2.PAGE7 change SDCARD IO use the EMMC group,and SDCARD power supply from AON_DVDD_3V3. 3.PAGE18 change DC JACK PN.

V1.2.1 | 2026-01-05 | xie yibei | 1.PAGE02&03&19 add DDR VDDQ note for DDR2\ DDR3L\LPDDR3.

1.PAGE19 add DDR VDDQ note for LPDDR2/DDR3, default LPDDR2.
2.PAGE06&11 add VSync and PWDN circuits for CAM Sensor .
3.PAGE18 change Nor Flash default.
4.PAGE23 NC charger circuits IC.

V1.3 | 2026-06-09 | xie yibei | 5.PAGE3 add Power Sequence.

xieyibei@axera-tech.com
zhoupengfei@axera-tech.com

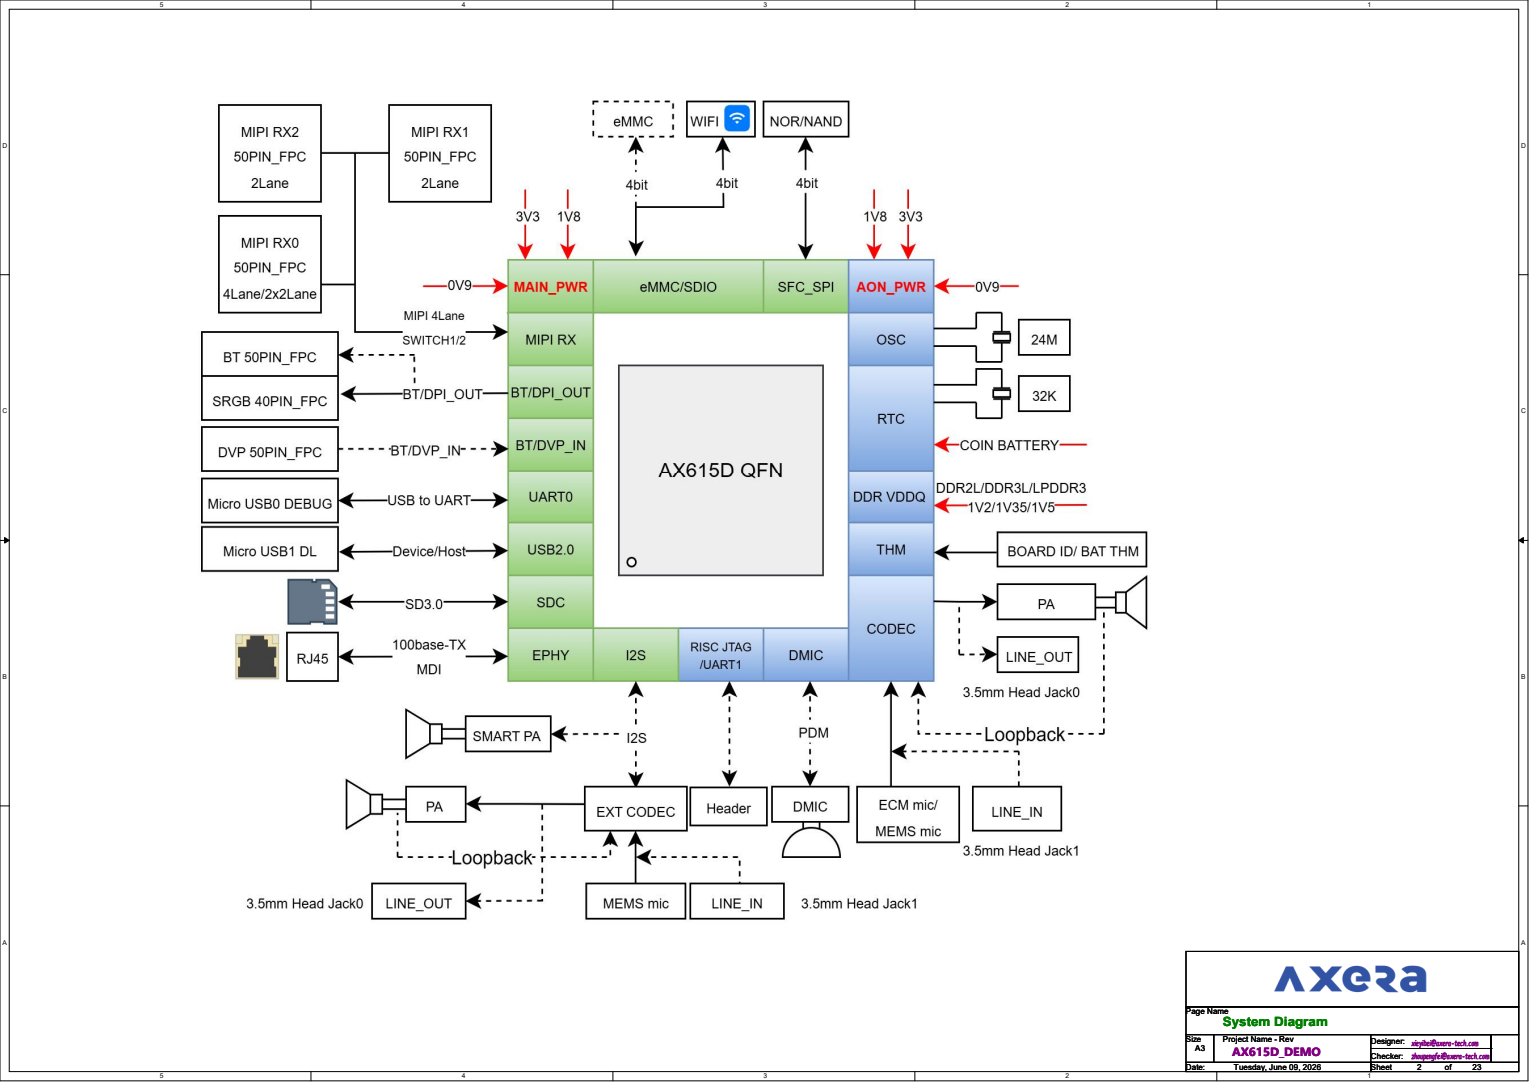
[picture p10: page 3]
System Diagram; Tuesday, June 09, 2026

*1

# AON_DDRV_1V35

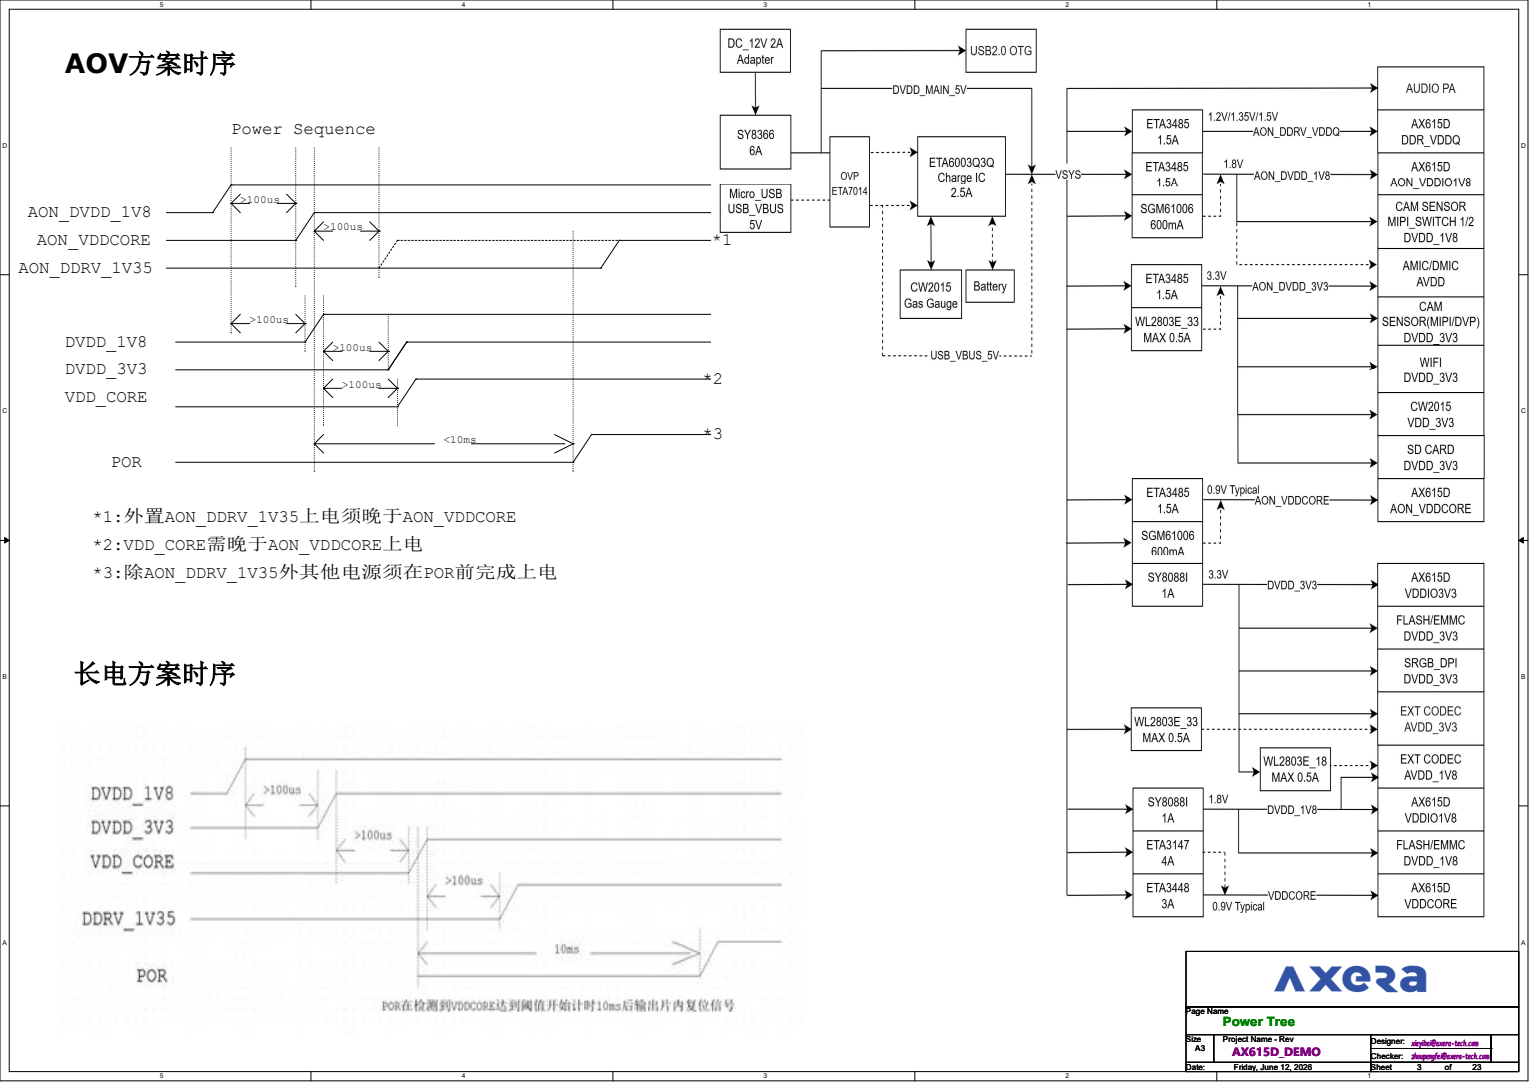
[picture p11: page 4]
*1:外置AON_DDRV_1V35上电须晚于AON_VDDCORE; AON_VDDCORE; Power Sequence; *2:VDD_CORE需晚于AON_VDDCORE上电; AON_DVDD_1V8; DVDD_3V3; POR; DVDD_1V8; VDD_CORE; *3:除AON_DDRV_1V35外其他电源须在POR前完成上电; 长电方案时序; AOV方案时序; Power Tree; Friday, June 12, 2026

I2C BUS | Host Domain | Device Domain | Device | Device Addr | Remark
WRITE | READ

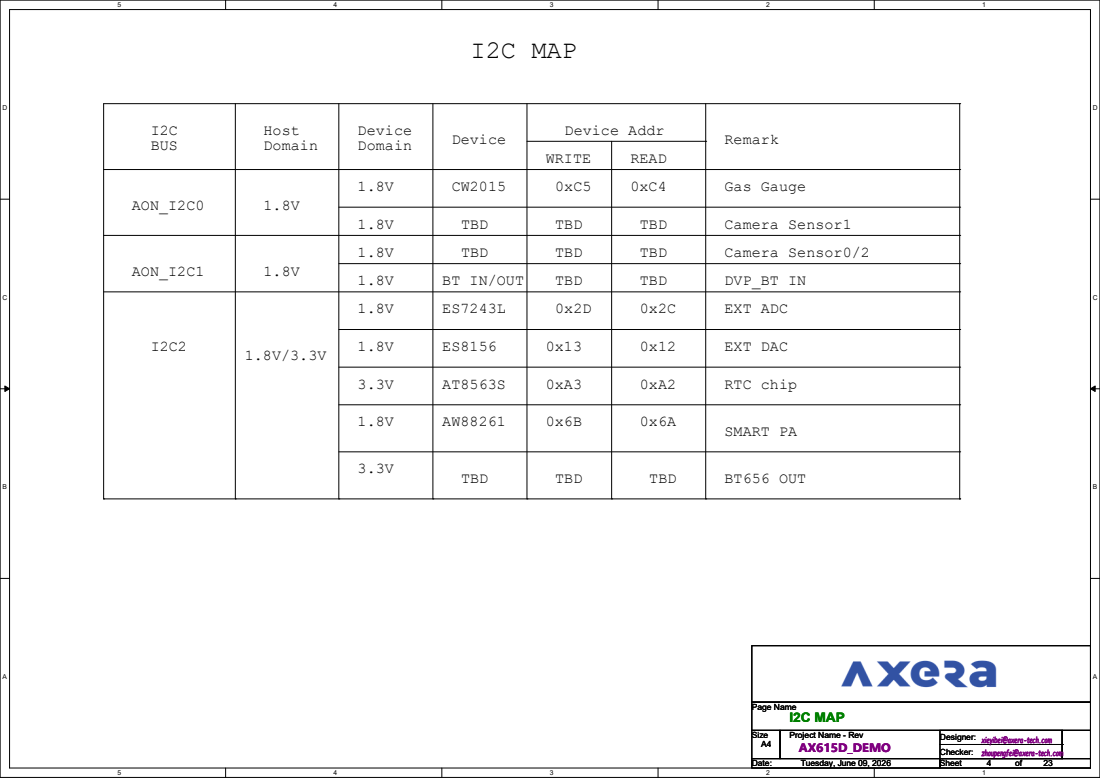
[picture p12: page 5]
I2C MAP; Page Name I2C MAP; Tuesday, June 09, 2026

AON_I2C0 | 1.8V | 1.8V | CW2015 | 0xC5 | 0xC4 | Gas Gauge

1.8V | TBD | TBD | TBD | Camera Sensor1

AON_I2C1 | 1.8V | 1.8V | TBD | TBD | TBD | Camera Sensor0/2

1.8V | BT IN/OUT | TBD | TBD | DVP_BT IN

I2C2 | 1.8V/3.3V | 1.8V | ES7243L | 0x2D | 0x2C | EXT ADC

1.8V | ES8156 | 0x13 | 0x12 | EXT DAC
3.3V | AT8563S | 0xA3 | 0xA2 | RTC chip
1.8V | AW88261 | 0x6B | 0x6A | SMART PA
3.3V | TBD | TBD | TBD | BT656 OUT

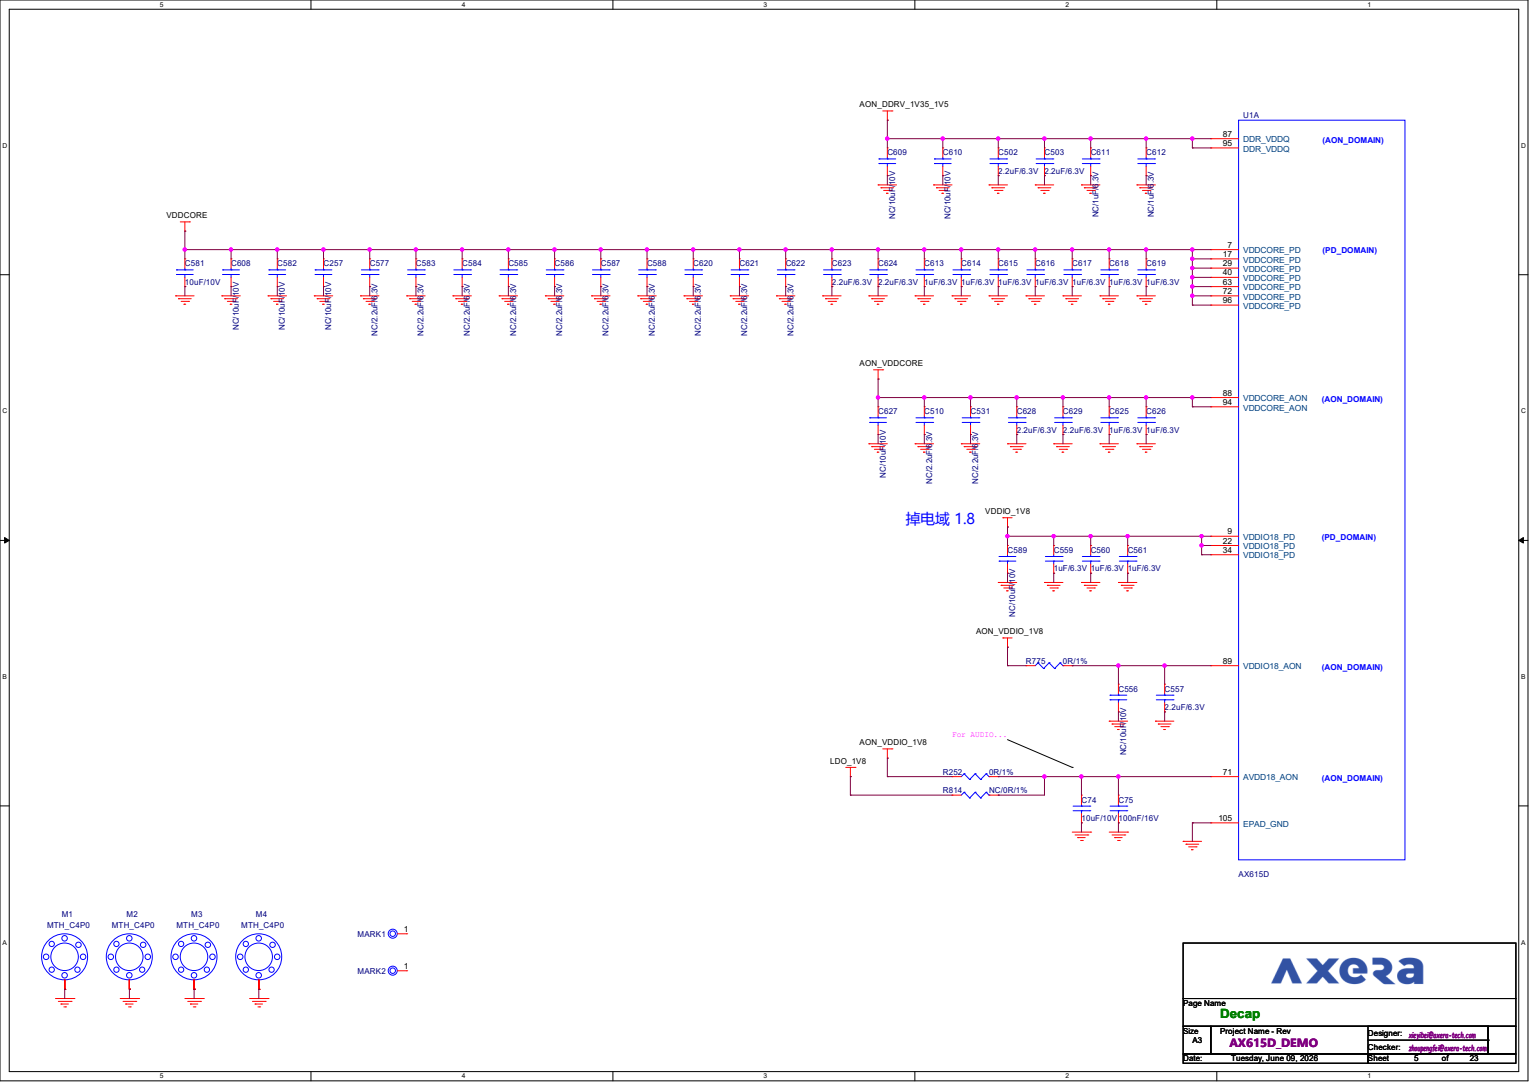
[picture p13: page 6]

BOND1 | BOND0 | BOOT OPTION
0

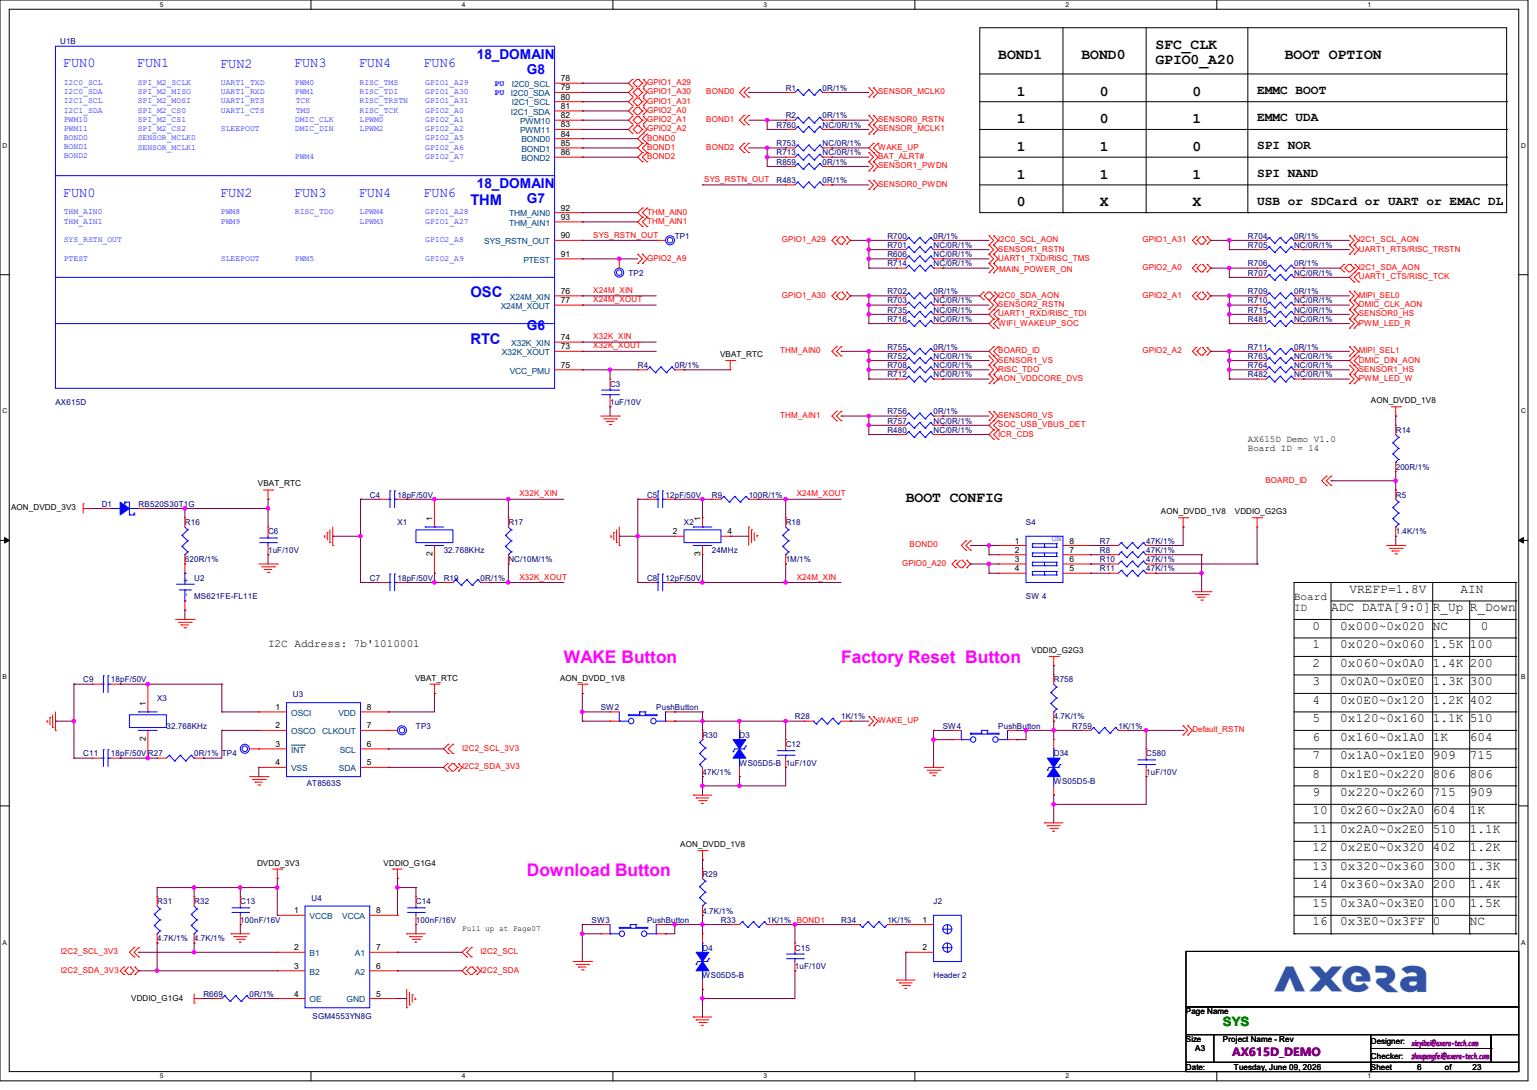
[picture p14: page 7]

EMMC BOOT
EMMC UDA
SPI NOR
SPI NAND
USB or SDCard or UART or EMAC DL

Board ID | VREFP=1.8V | AIN
ADC DATA[9:0] | R_Up | R_Down
0 | 0x000~0x020 | NC | 0
1 | 0x020~0x060 | 1.5K | 100
2 | 0x060~0x0A0 | 1.4K | 200
3 | 0x0A0~0x0E0 | 1.3K | 300
4 | 0x0E0~0x120 | 1.2K | 402
6 | 0x160~0x1A0 | 1K | 604
7 | 0x1A0~0x1E0 | 909 | 715

8 | 0x1E0~0x220 | 806 | 806
10 | 0x260~0x2A0 | 604 | 1K
11 | 0x2A0~0x2E0 | 510 | 1.1K
12 | 0x2E0~0x320 | 402 | 1.2K
13 | 0x320~0x360 | 300 | 1.3K
14 | 0x360~0x3A0 | 200 | 1.4K
15 | 0x3A0~0x3E0 | 100 | 1.5K
16 | 0x3E0~0x3FF | 0 | NC

G4

## Default 1.8V

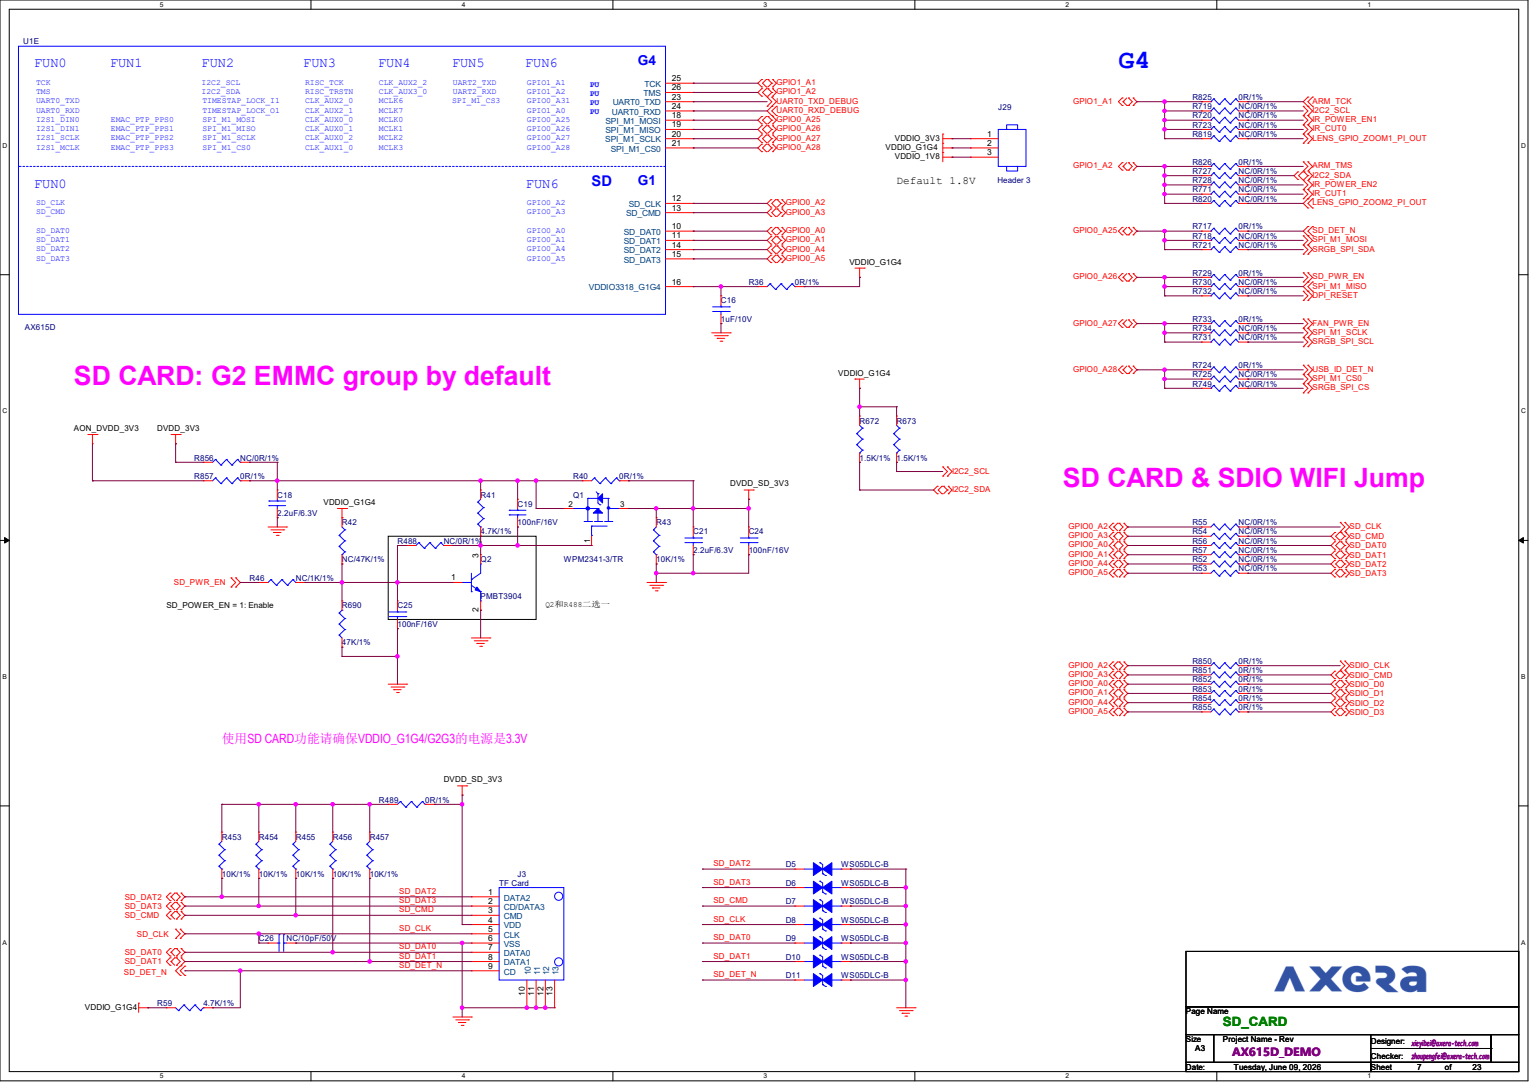
[picture p15: page 8]

SD CARD: G2 EMMC group by default

SD CARD & SDIO WIFI Jump

## Default 3.3V

# SPI FLASH

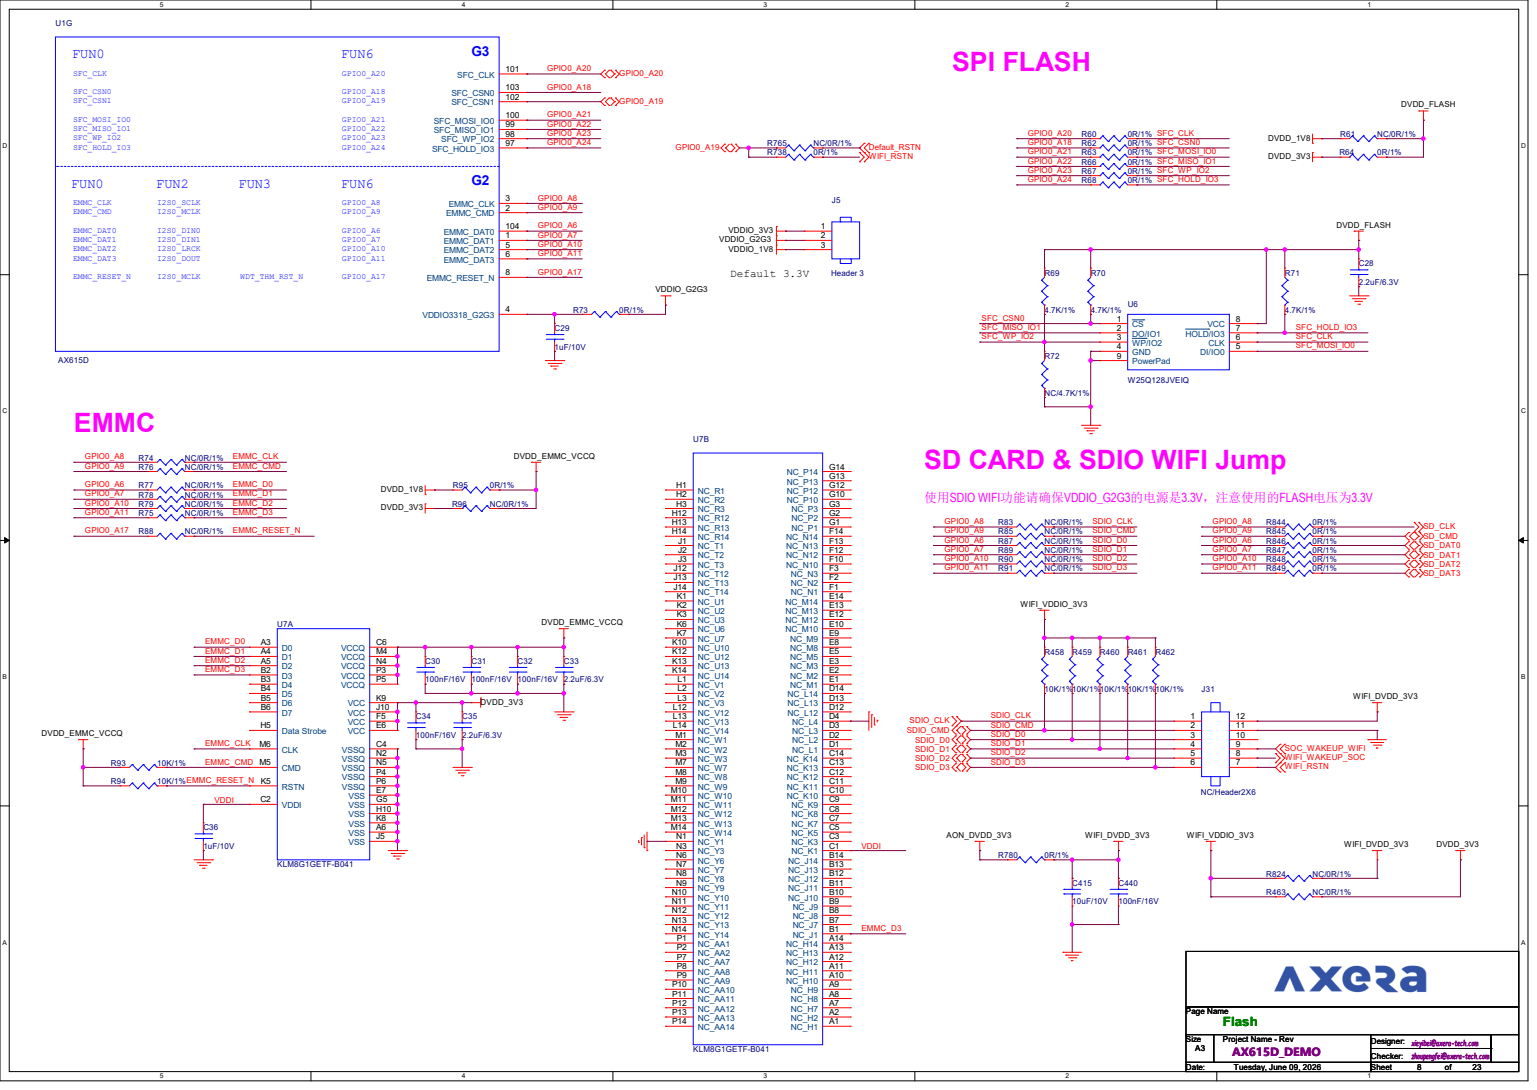
[picture p16: page 9]

SD CARD & SDIO WIFI Jump

# USB

## USB Port

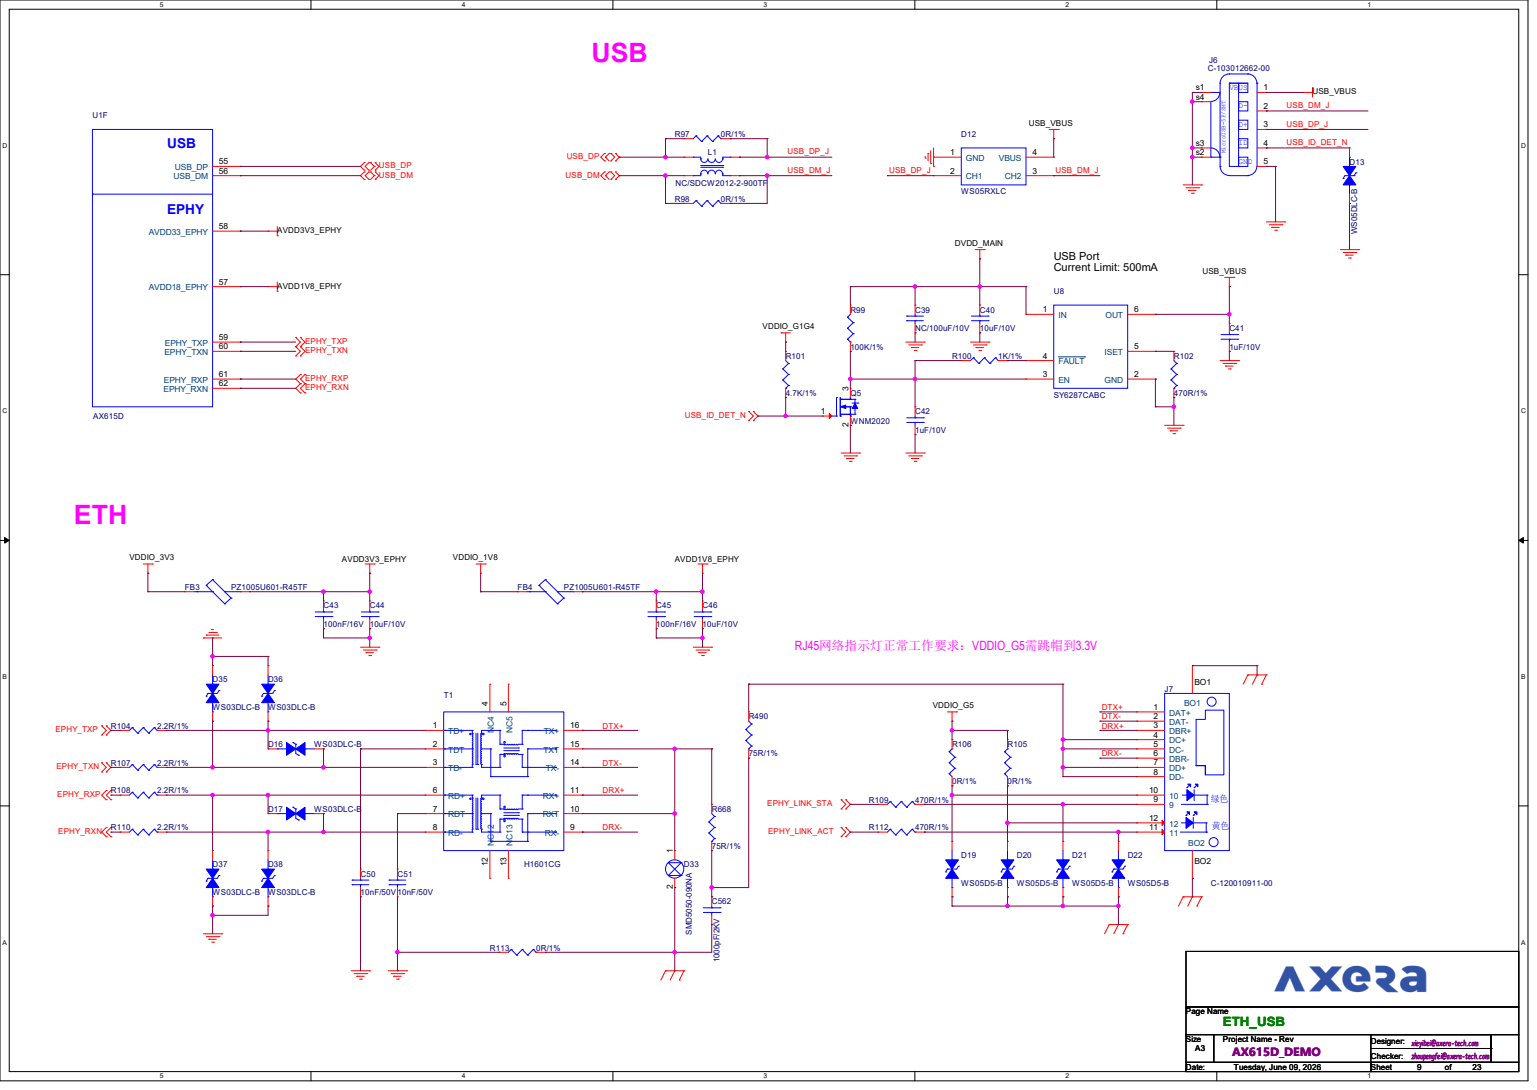
[picture p17: page 10]

## Default 1.8V

FUN0 | FUN1 | FUN2 | FUN4 | FUN5

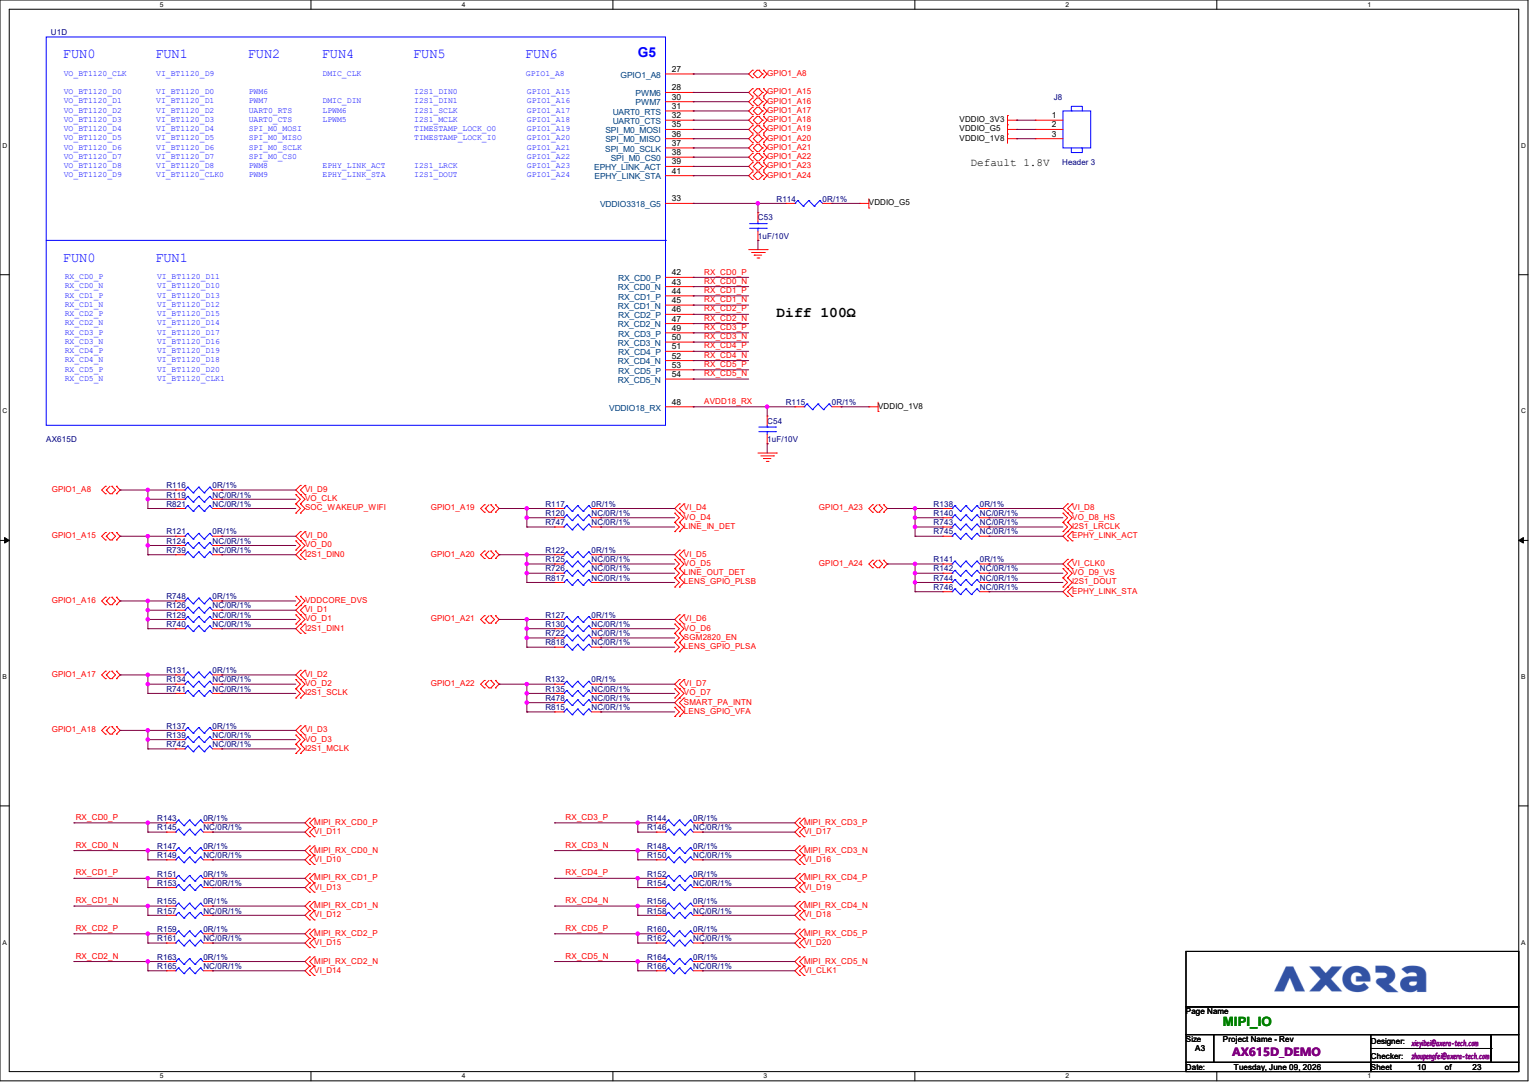
[picture p18: page 11]

RX0：4LANE OR 2X2LANE | RX1：1x2LANE | RX2：1x2LANE

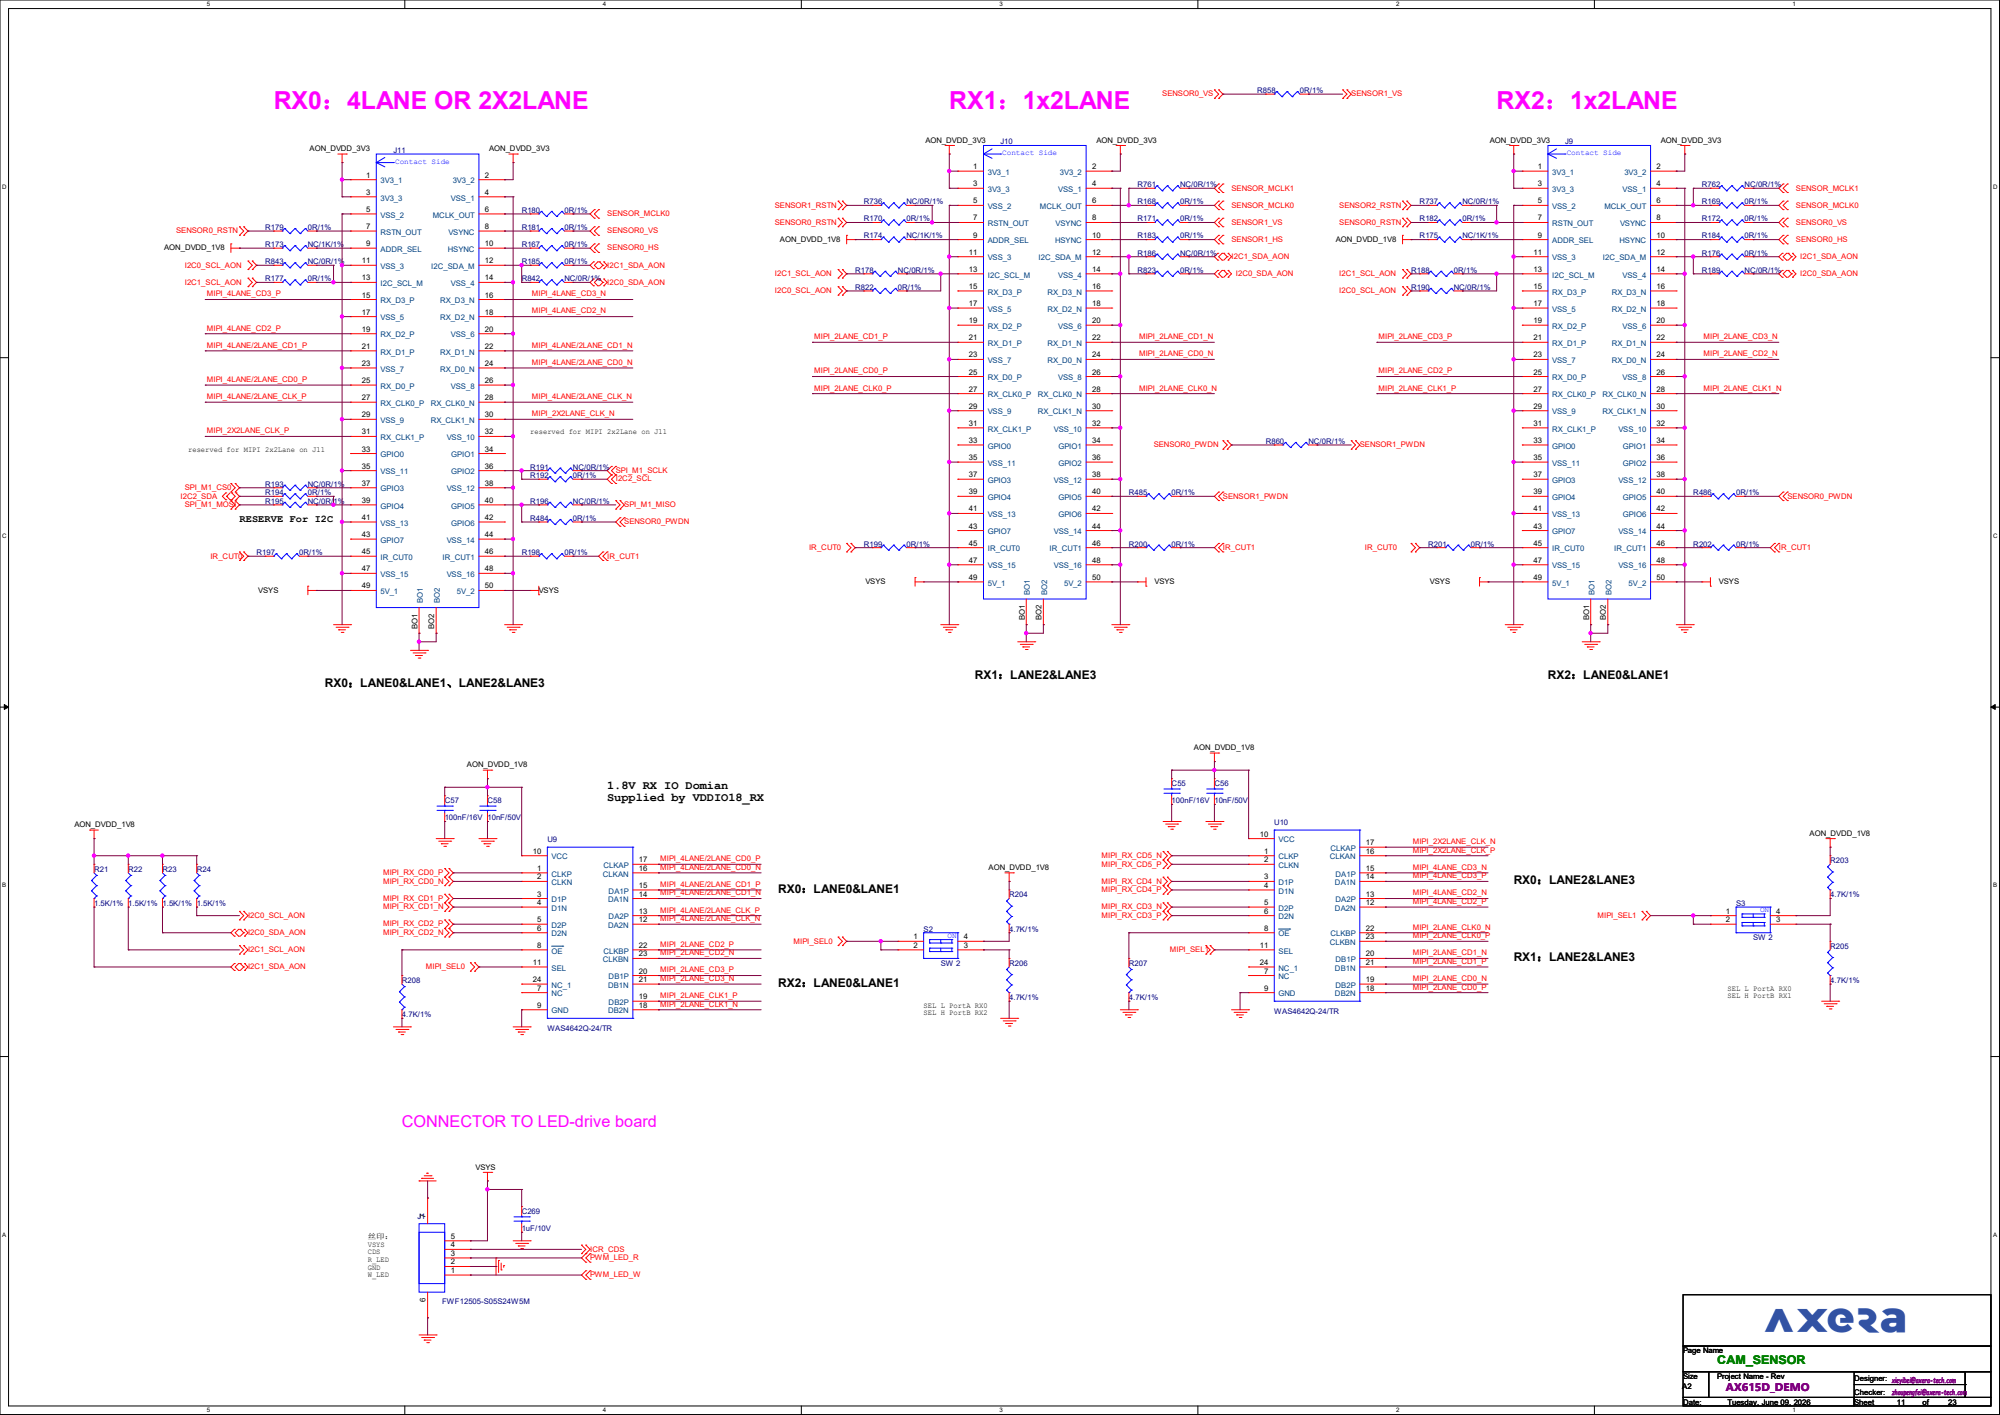
[picture p19: page 12]

MIPI_2X2LANE_CLK_N
reserved for MIPI 2x2Lane on J11

MIPI_2X2LANE_CLK_P

CONNECTOR TO LED-drive board

D

V

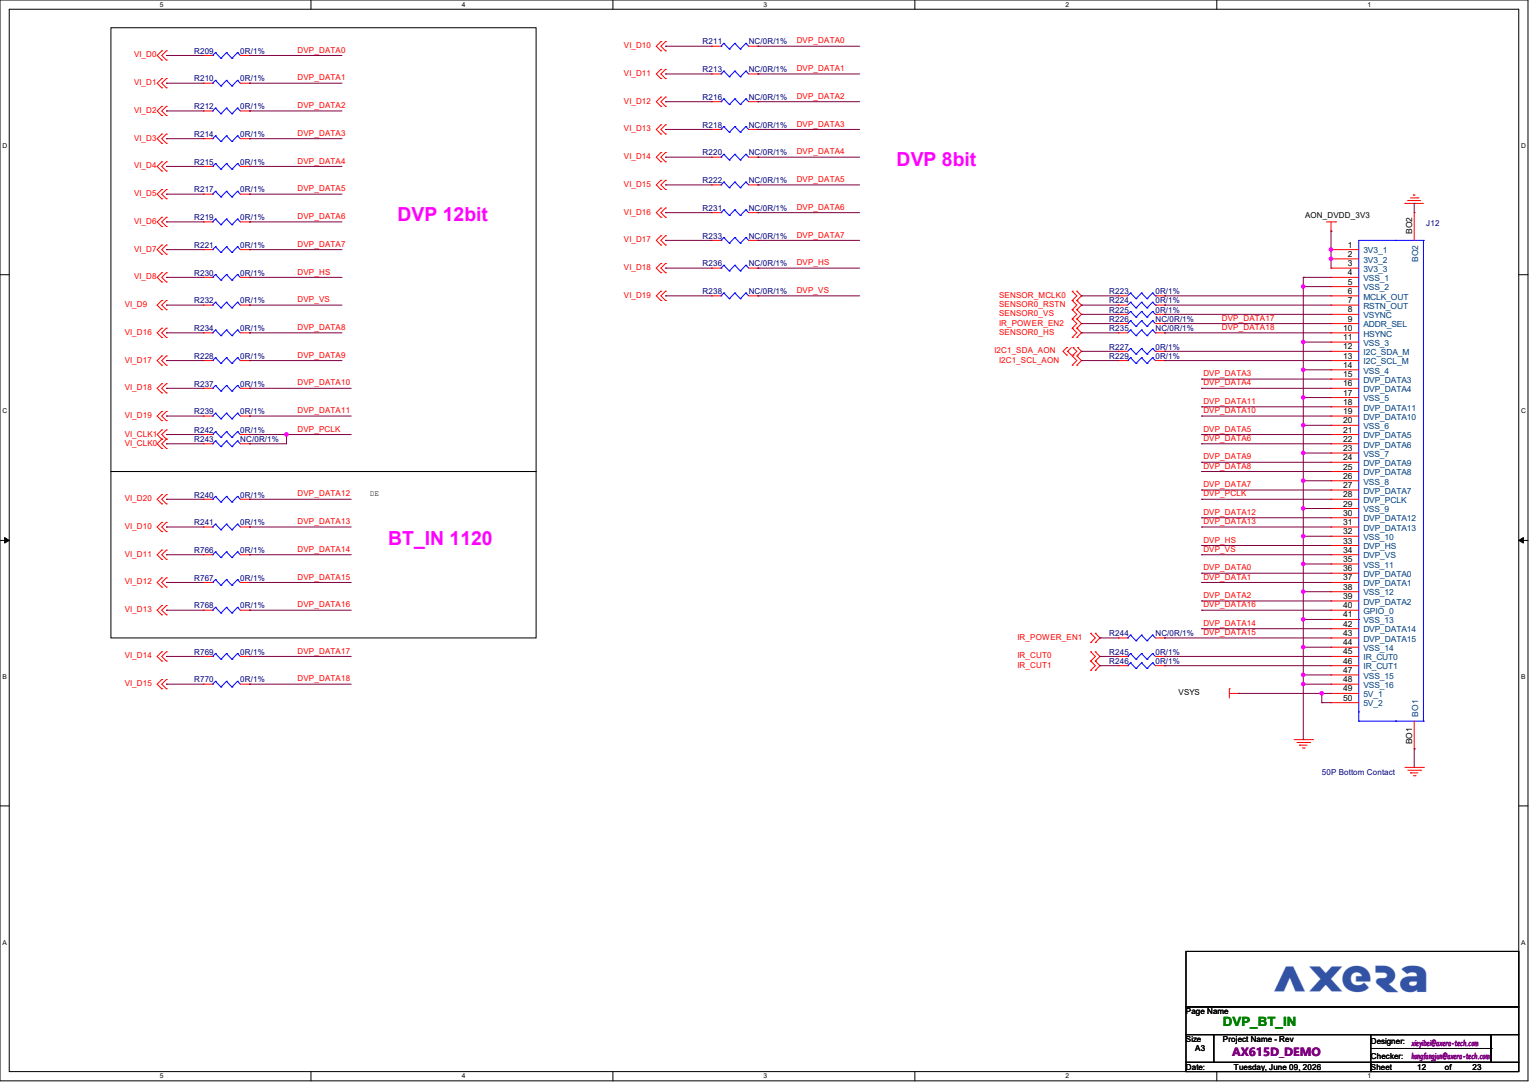
[picture p20: page 13]
S IR_POWER_E N; S I2C1_SCL_AO N I2C1_SDA_AON IR_POWER; 1 IR_CUT0 IR_CUT1; Siz; sig; Checker: _DEMO; xie; yib; ngj; PIO

SRGB LCD | BT656 OUT & LENS DRIVER

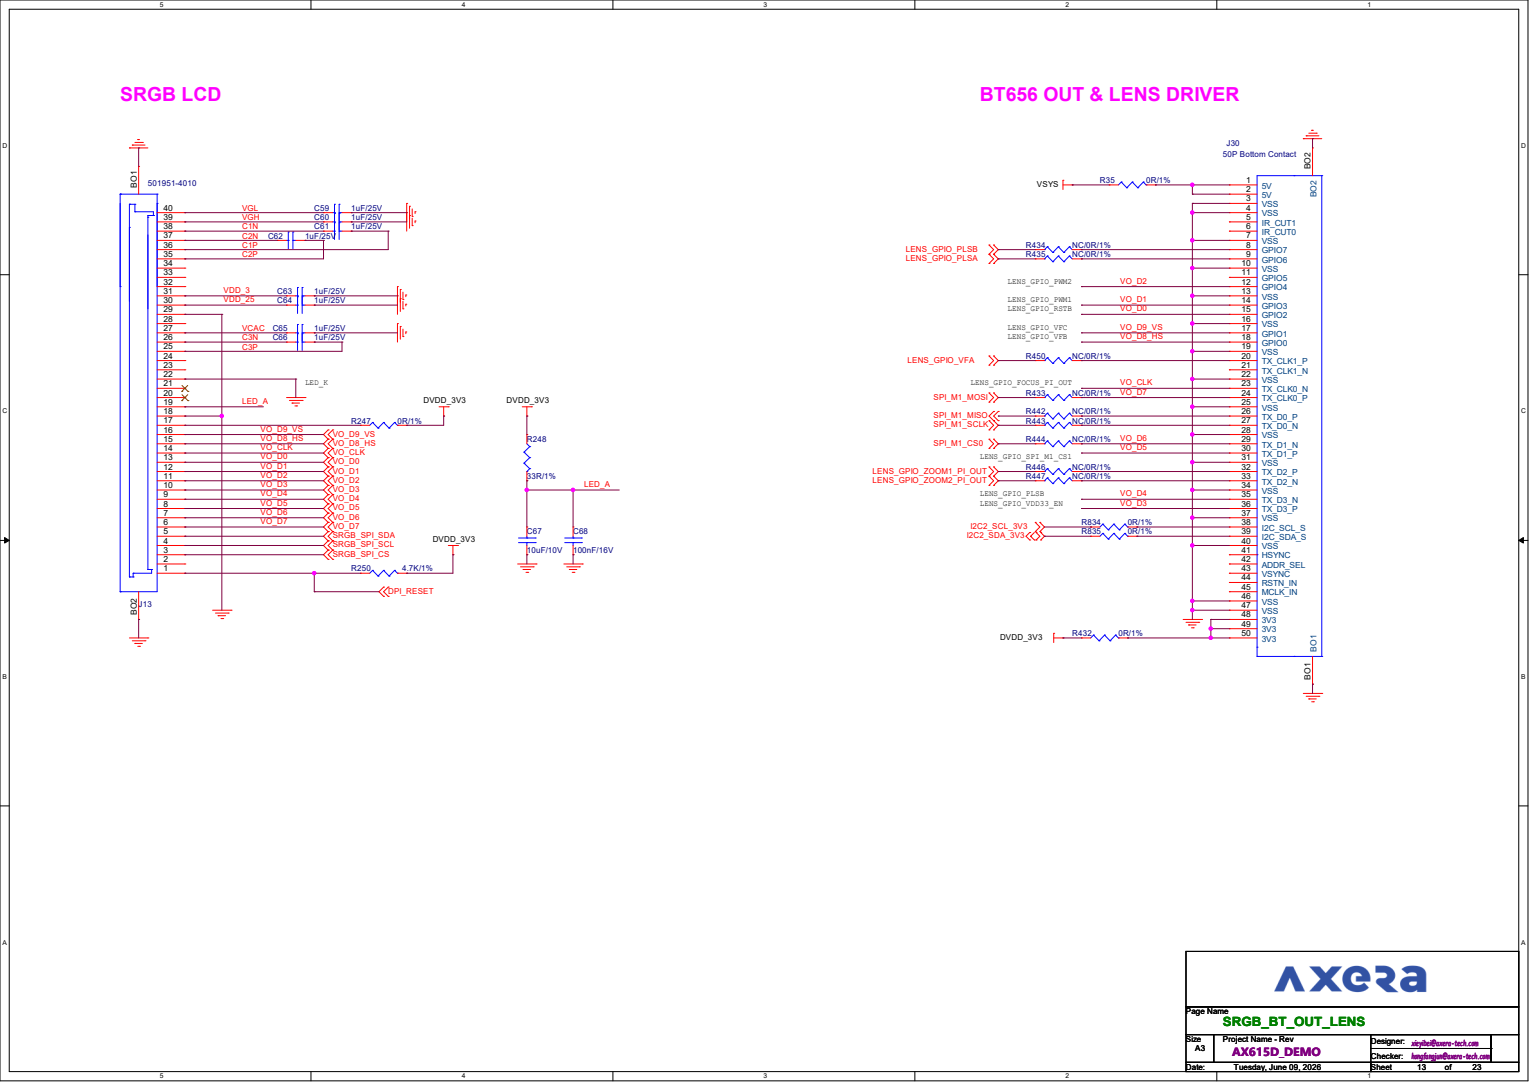
[picture p21: page 14]

38 C1N C61 | 1uF/25V
37 C2N C62 | 1uF/25V

26 | C3N C66 | 1uF/25V
25 | C3P

hongfangjun@axera-tech.com

# INT_MEMS_AMIC

ON

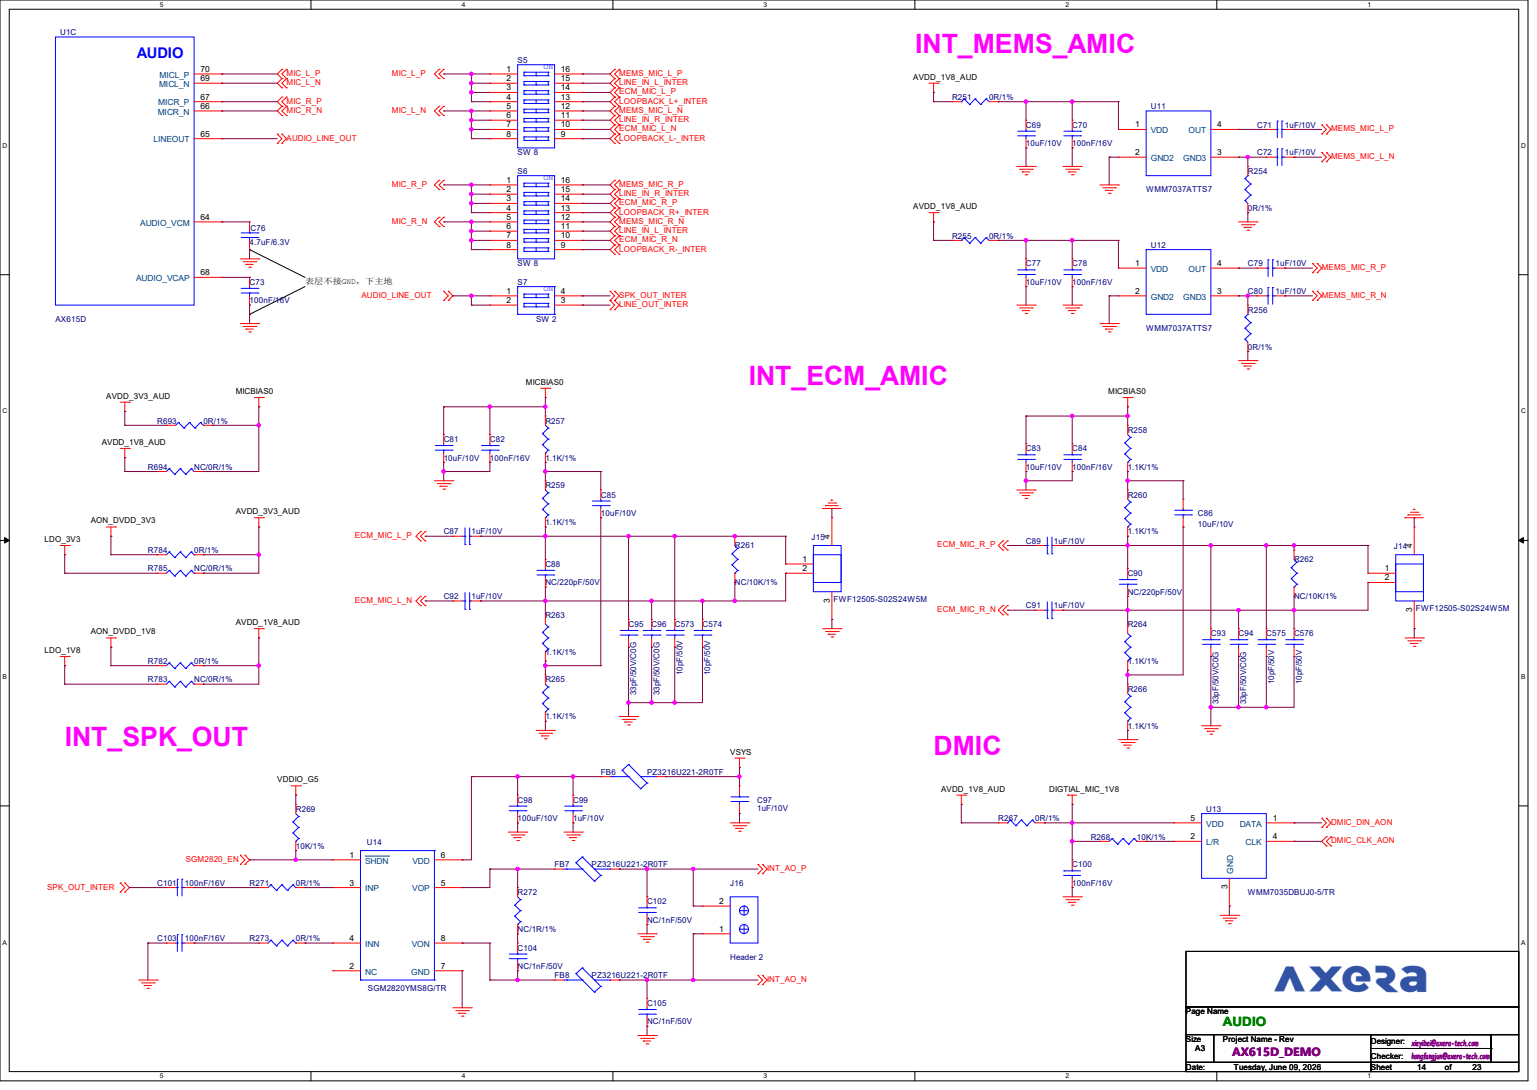
[picture p22: page 15]

## 调试I2S，VDDIO_G5/VDDIO_G1G4为1.8V

# EXT_ADC

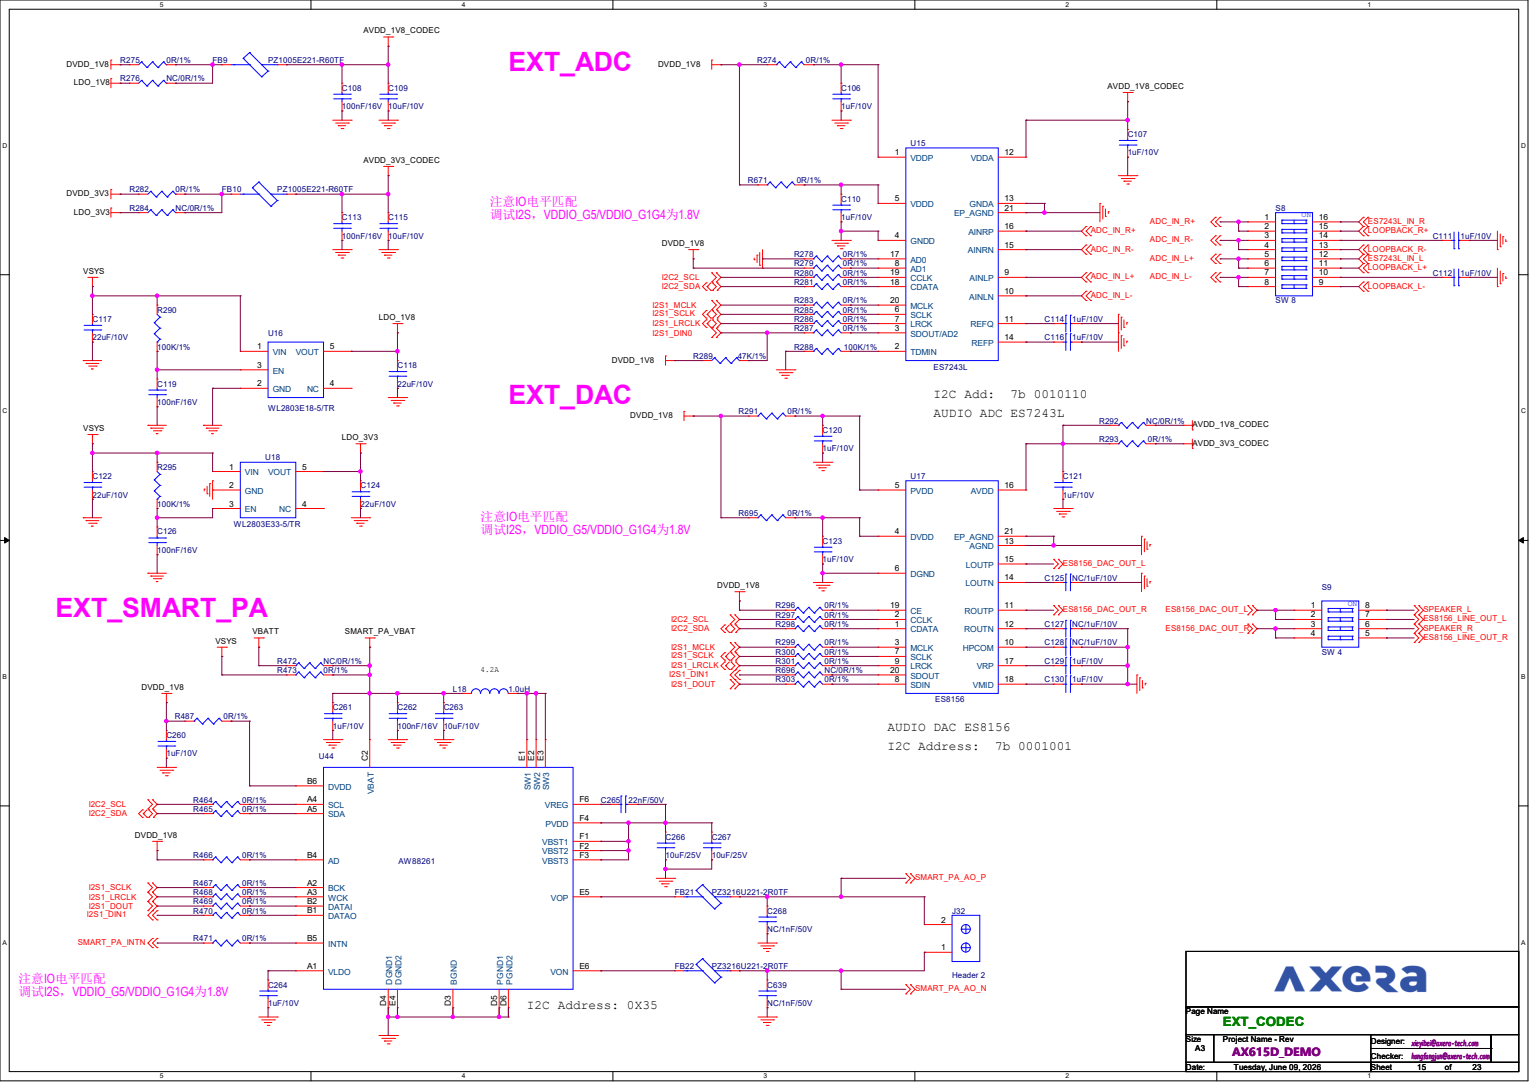
[picture p23: page 16]

# LINE_IN

# LINE_IN_DET, Internal Pull Up

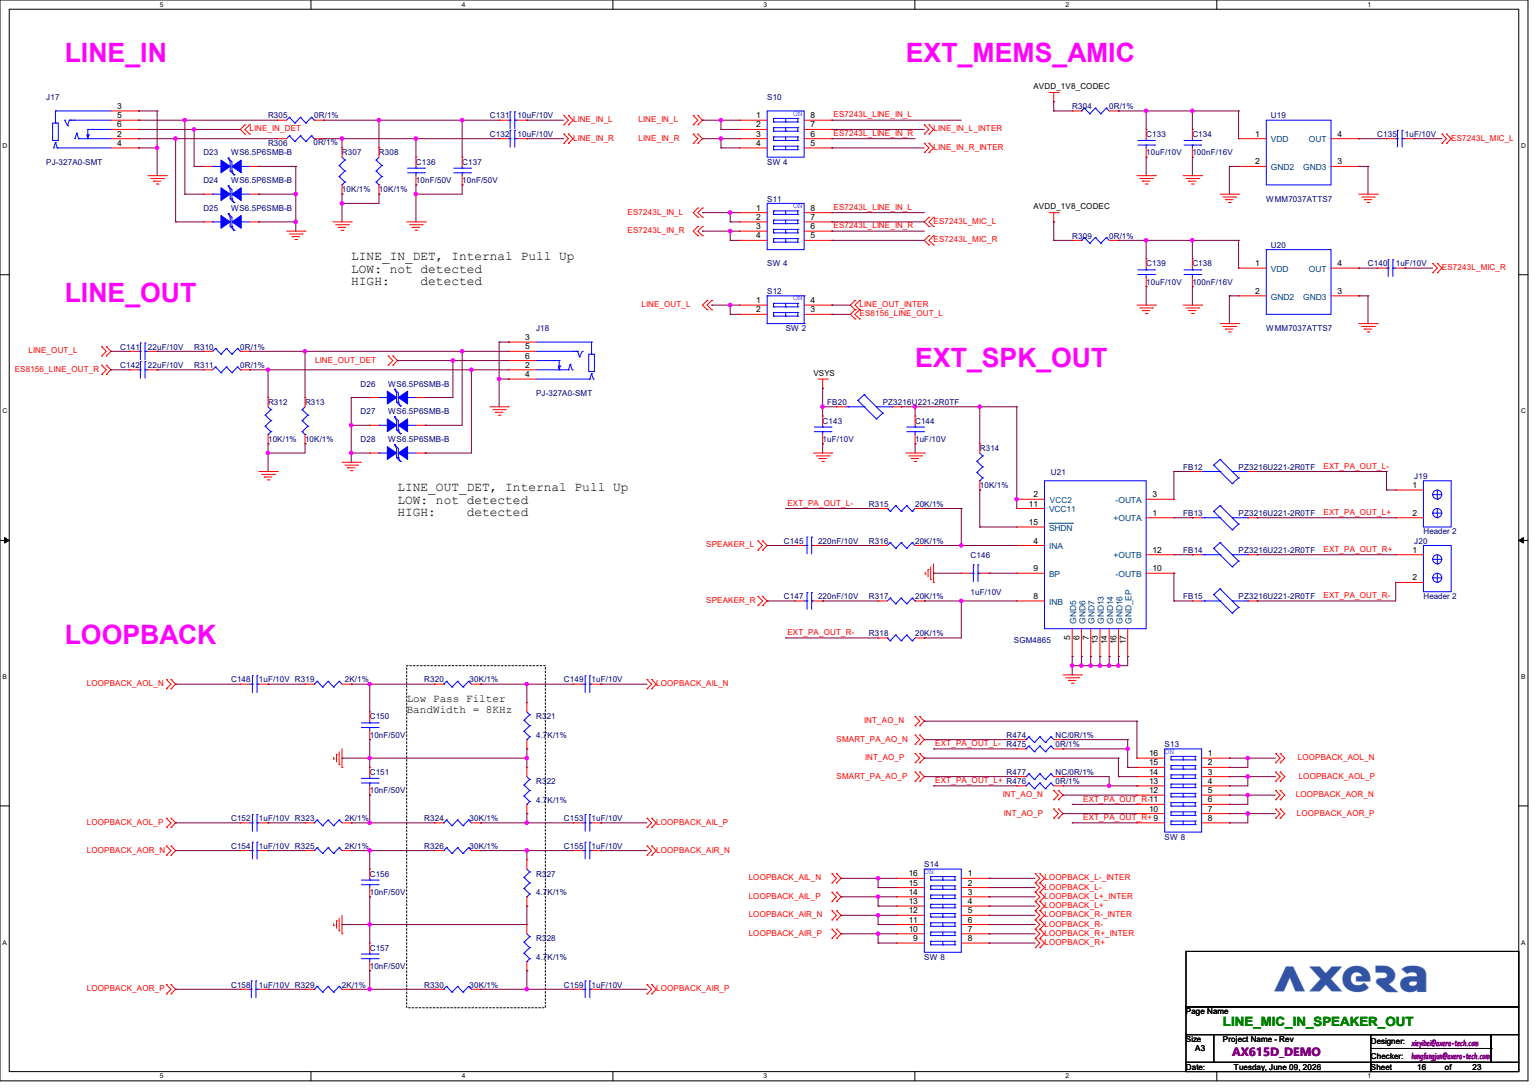
[picture p24: page 17]

# DIFF 90

# USB TO UART LOG

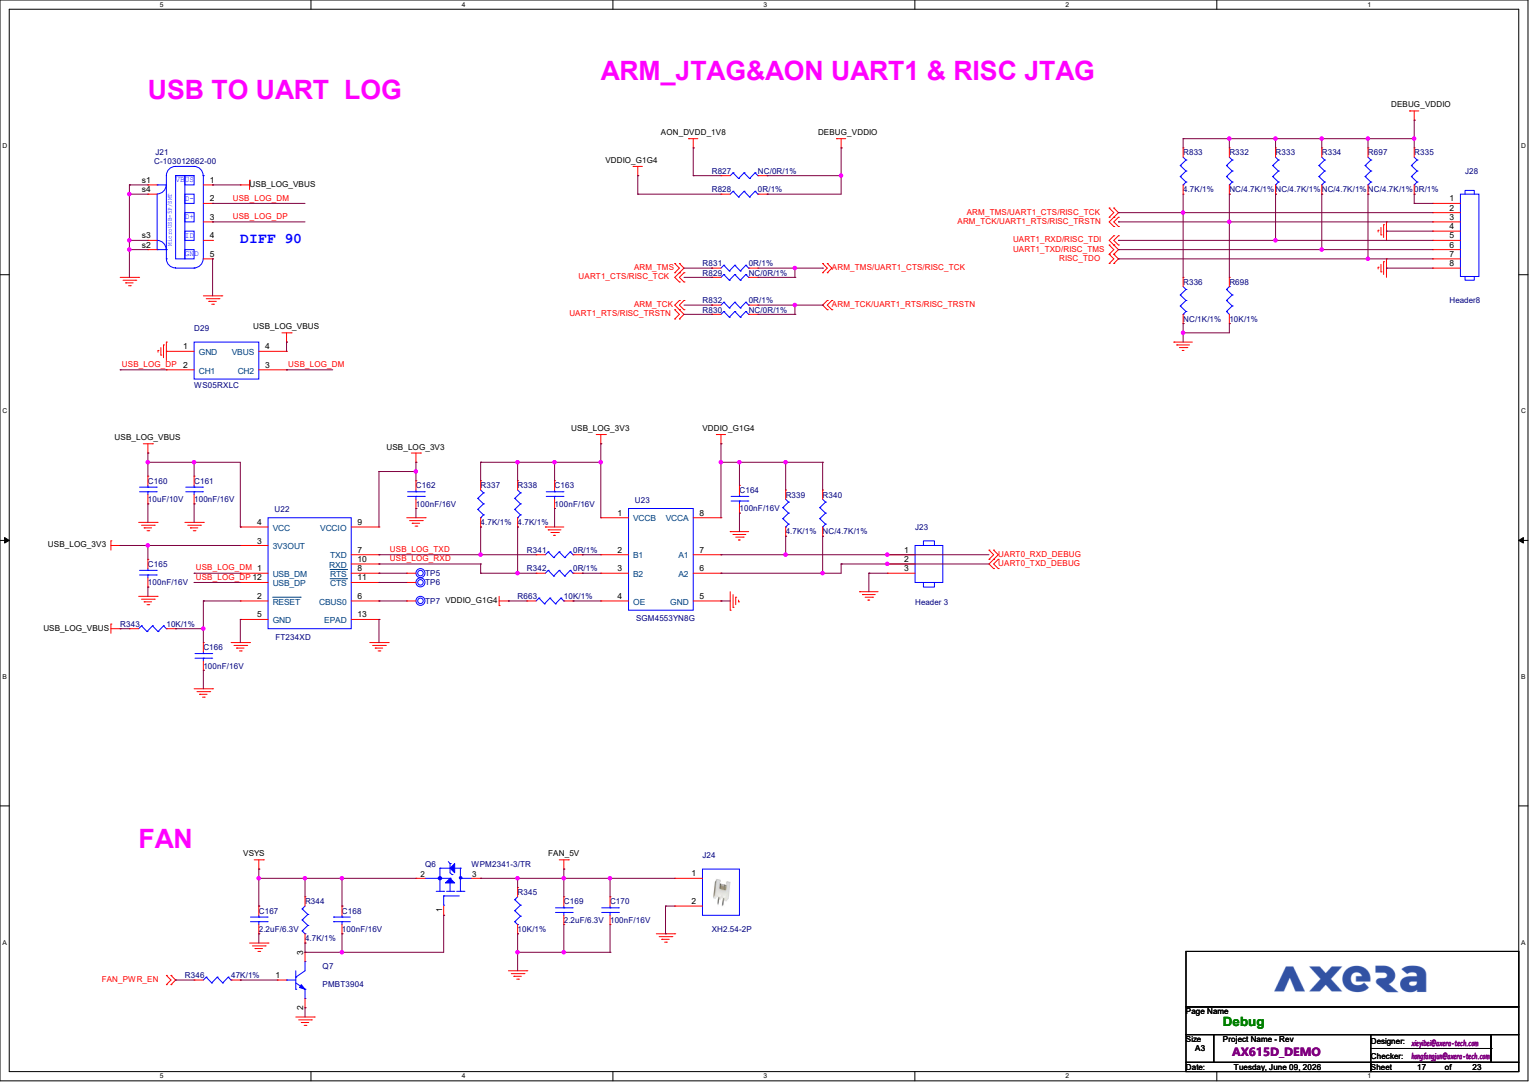
[picture p25: page 18]

# DC IN, 12V/2A

### Contact Side

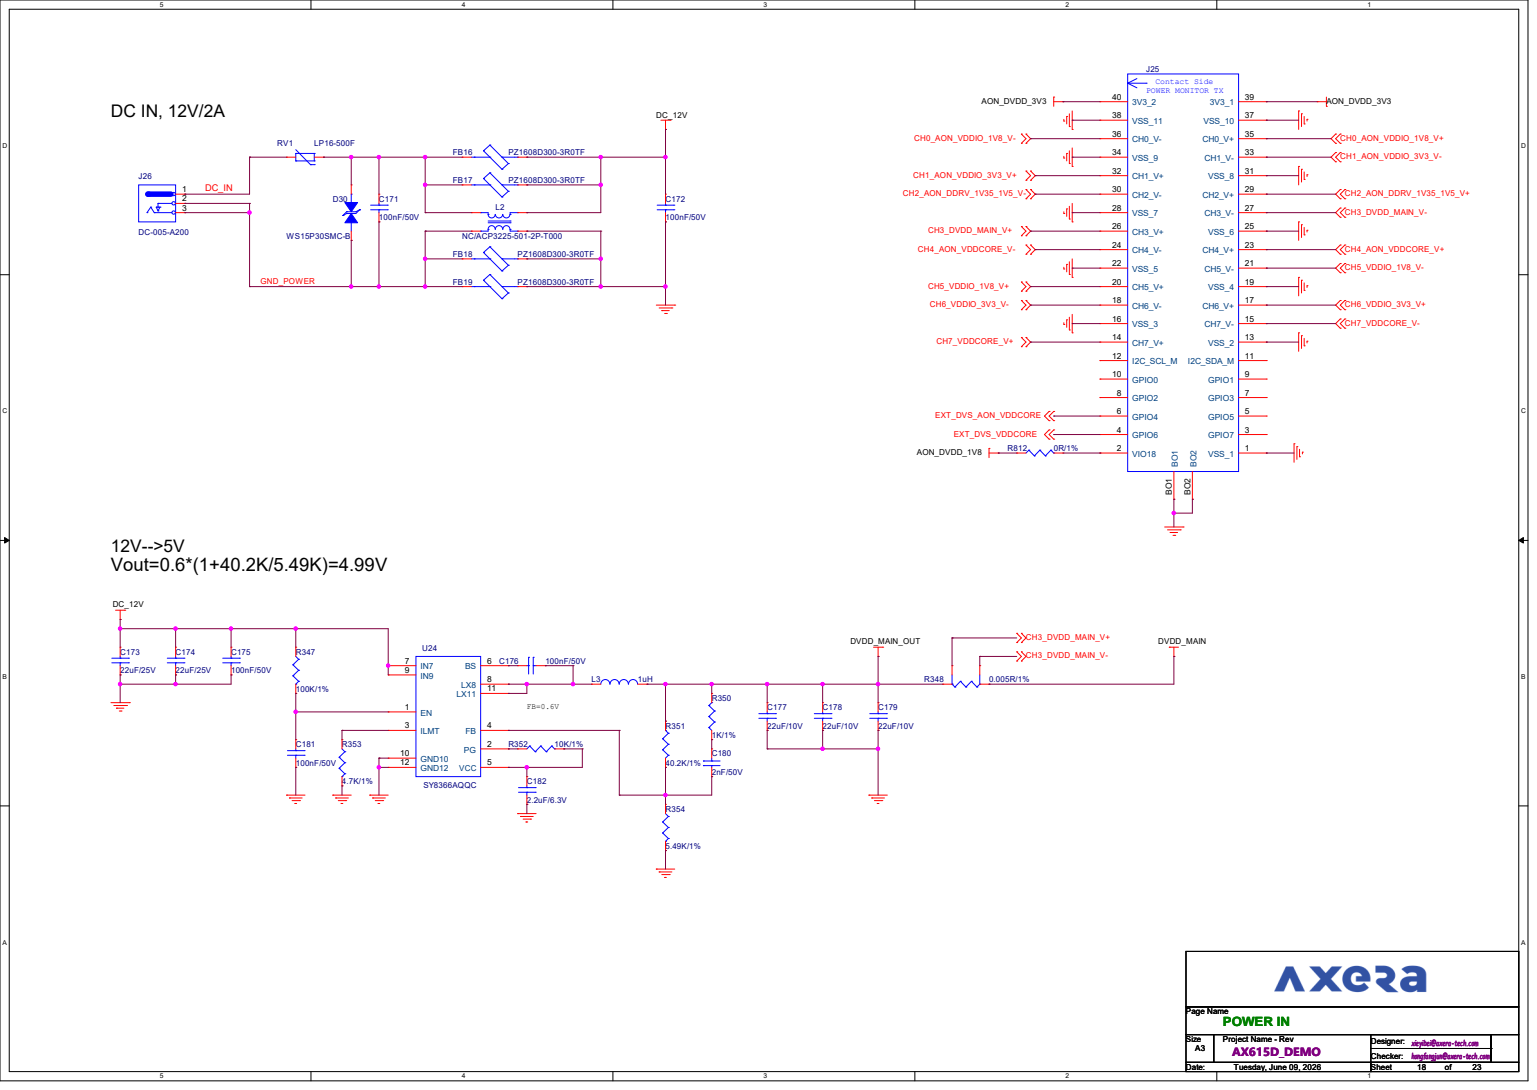
[picture p26: page 19]

# Vout=0.6*(1+200K/100K)=1.8V

# AON 1.8V FOR SOC / Sensor / AUDIO / （MIC）

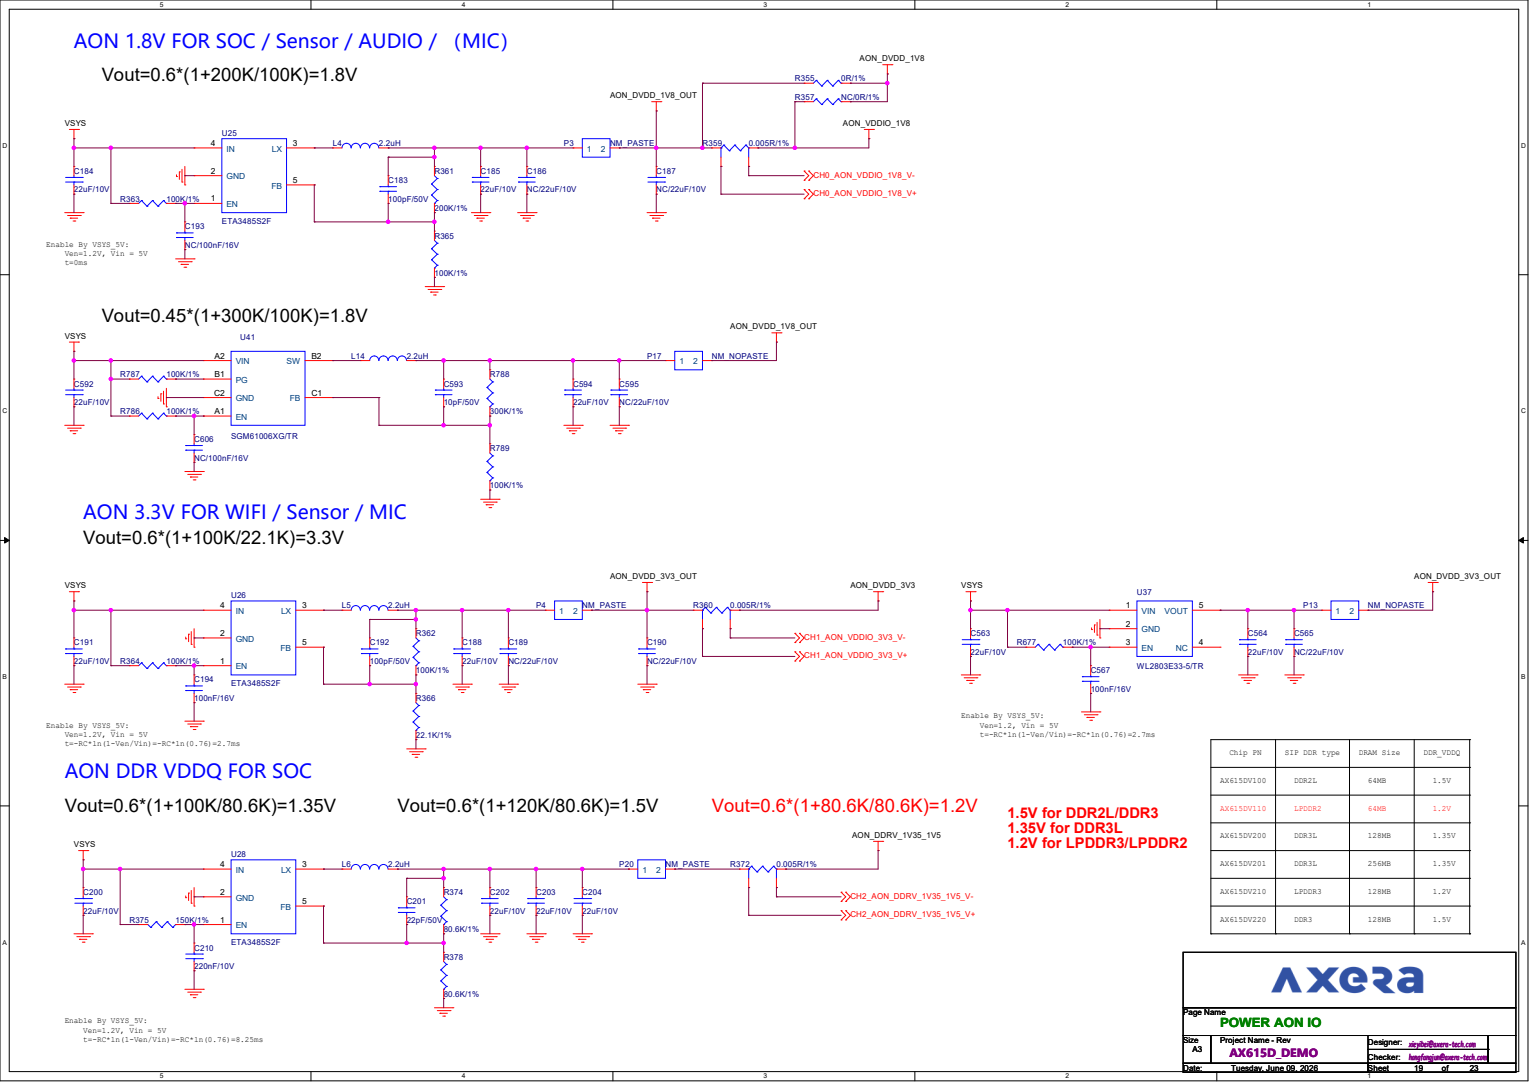
[picture p27: page 20]

AON 3.3V FOR WIFI / Sensor / MIC
Vout=0.6*(1+100K/22.1K)=3.3V

Enable By VSYS_5V:
Ven=1.2, Vin = 5V
t=-RC*ln(1-Ven/Vin)=-RC*ln(0.76)=2.7ms

Ven=1.2V, Vin = 5V
AON DDR VDDQ FOR SOC
Vout=0.6*(1+100K/80.6K)=1.35V

Chip PN | SIP DDR type | DRAM Size | DDR_VDDQ

AX615DV100 | DDR2L | 64MB | 1.5V

AX615DV110 | LPDDR2 | 64MB | 1.2V

AX615DV200 | DDR3L | 128MB | 1.35V

AX615DV201 | DDR3L | 256MB | 1.35V

AX615DV210 | LPDDR3 | 128MB | 1.2V

AX615DV220 | DDR3 | 128MB | 1.5V

t=-RC*ln(1-Ven/Vin)=-RC*ln(0.76)=8.25ms

0.6V

# AON VDDCORE FOR SOC

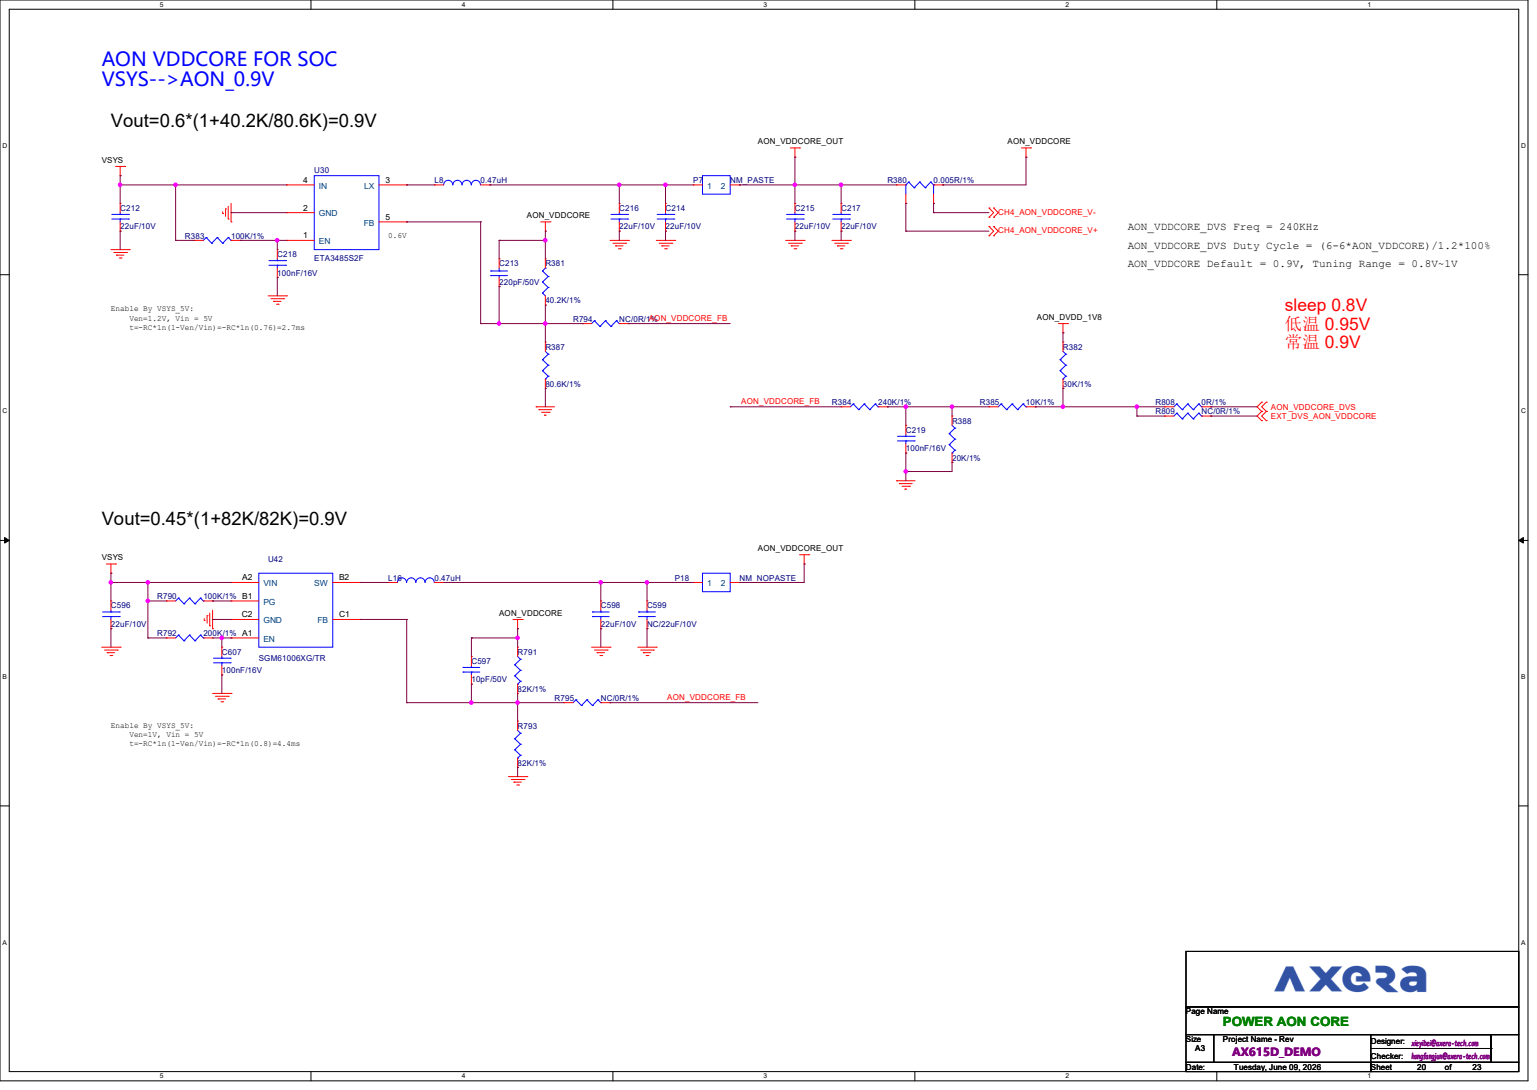
[picture p28: page 21]

Enable By VSYS_5V:
Ven=1.2V, Vin = 5V
t=-RC*ln(1-Ven/Vin)=-RC*ln(0.76)=2.7ms

Ven=1V, Vin = 5V
t=-RC*ln(1-Ven/Vin)=-RC*ln(0.8)=4.4ms

# Vout=0.6*(1+200K/100K)=1.8V

# MAIN 1.8V FOR SOC (ePHY )

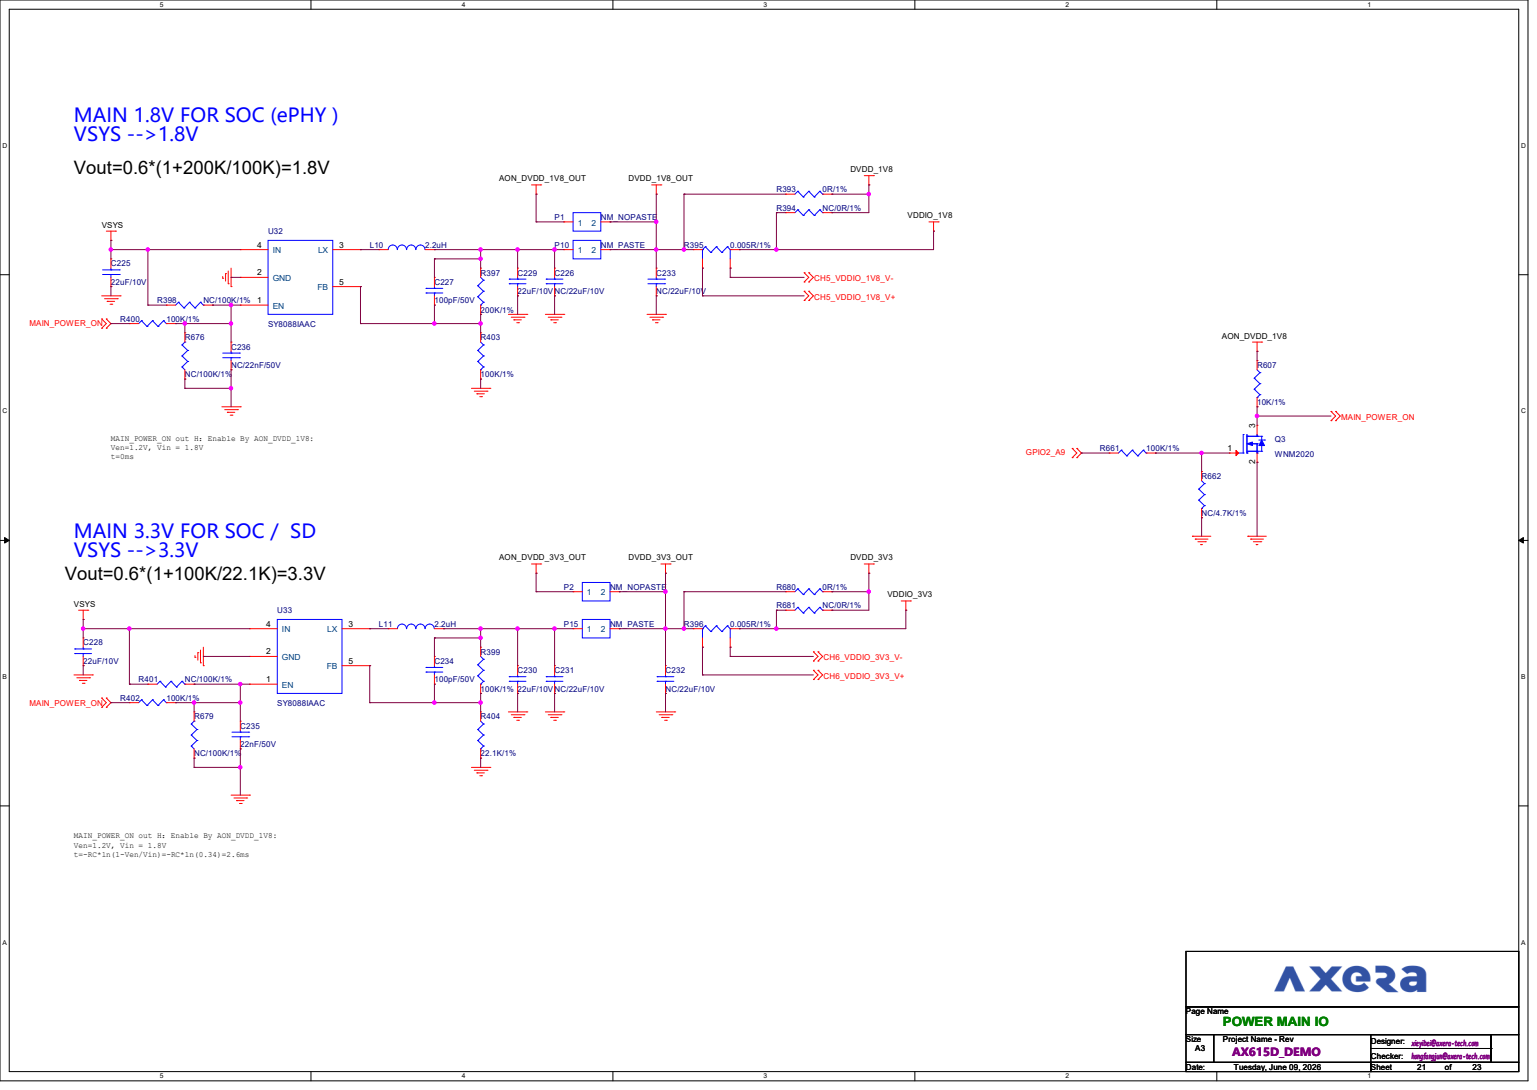
[picture p29: page 22]

MAIN 3.3V FOR SOC / SD
VSYS -->3.3V
Vout=0.6*(1+100K/22.1K)=3.3V

MAIN_POWER_ON out H：Enable By AON_DVDD_1V8:
Ven=1.2V, Vin = 1.8V
t=-RC*ln(1-Ven/Vin)=-RC*ln(0.34)=2.6ms

# MAIN VDDCORE FOR SOC VSYS -->0.9V

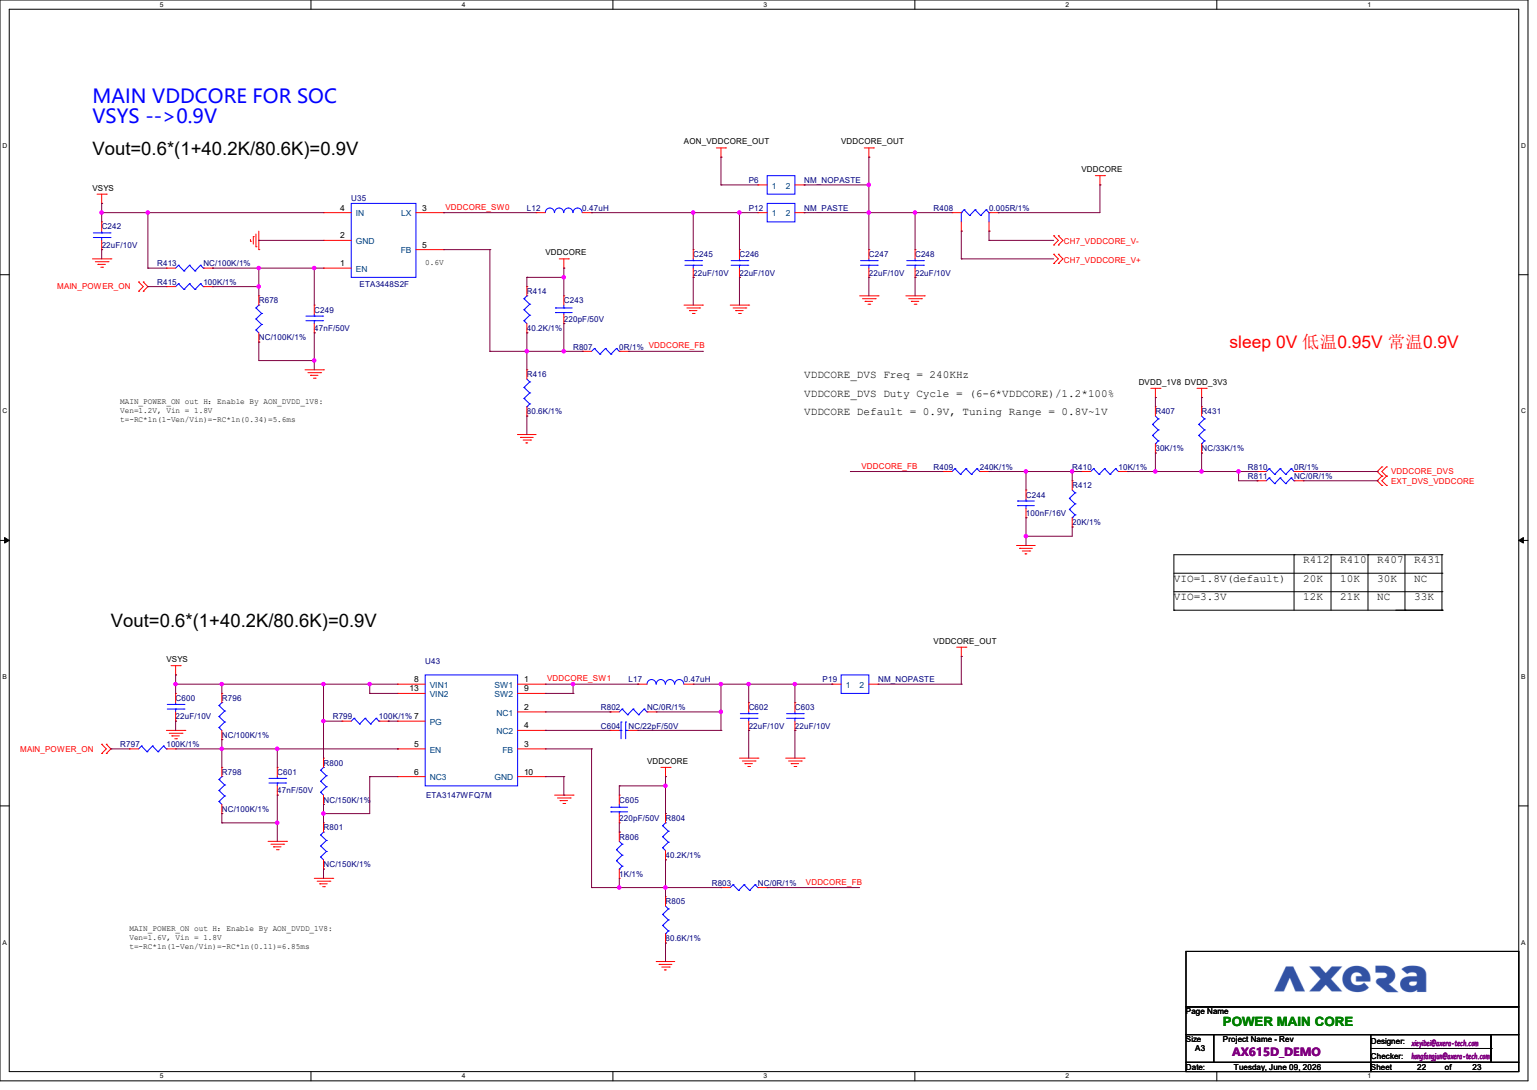
[picture p30: page 23]

VDDCORE_DVS Freq = 240KHz
VDDCORE_DVS Duty Cycle = (6-6*VDDCORE)/1.2*100%
VDDCORE Default = 0.9V, Tuning Range = 0.8V~1V

MAIN_POWER_ON out H：Enable By AON_DVDD_1V8:
Ven=1.2V, Vin = 1.8V
t=-RC*ln(1-Ven/Vin)=-RC*ln(0.34)=5.6ms

VIO=1.8V(default) | 20K | 10K | 30K | NC
VIO=3.3V | 12K | 21K | NC | 33K

Ven=1.6V, Vin = 1.8V
t=-RC*ln(1-Ven/Vin)=-RC*ln(0.11)=6.85ms

# BAT IN typ 3.7V

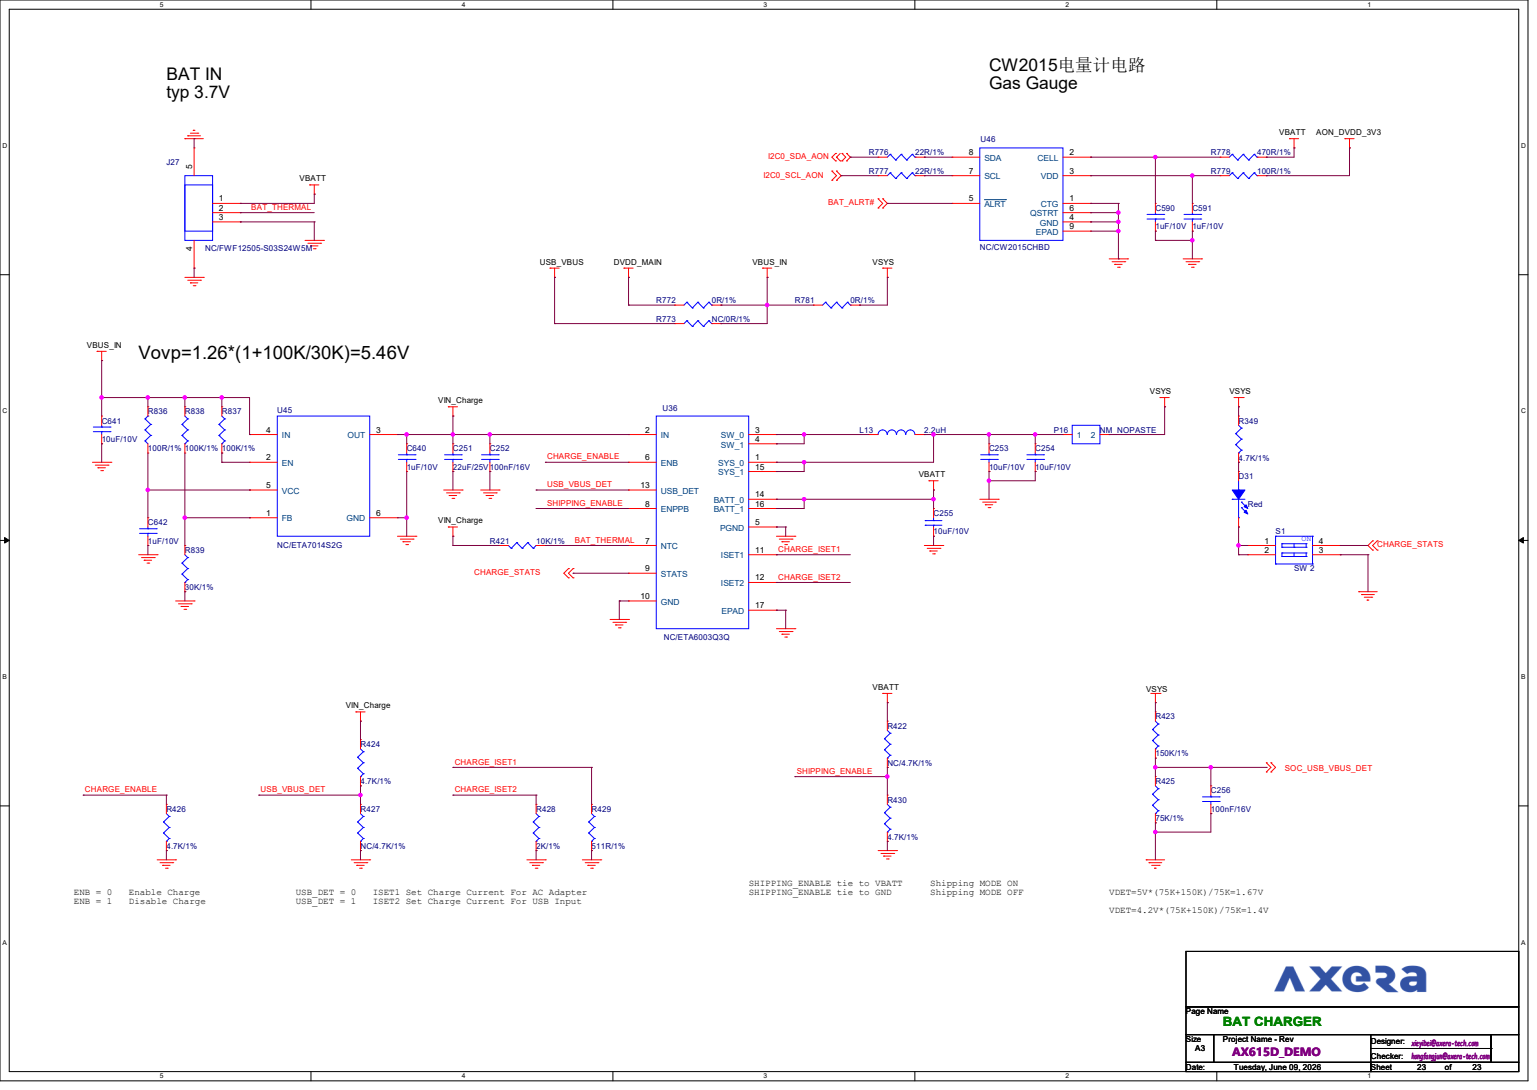
[picture p31: page 24]

USB_DET = 0 ISET1 Set Charge Current For AC Adapter
USB_DET = 1 ISET2 Set Charge Current For USB Input
