liyue75/pcb/(list of files, drawings)

Other design files:
AX615D_DEMO_V1.3_SVN/AX615D_DEMO_V1_3.DSN
