liyue75/pcb/(commit log)

2026-10-22 Add AX615 stereo PCB reference package
    [AX615D_DEMO_V1_3.BRD, AX615D_DEMO_V1_3.DSN, AX615D_DEMO_V1_3_BOM.xlsx, AX615D_PIN_OUT.xlsx, AX615_AVL_V1.1.xlsx]
2026-10-22 Add AX615 stereo PCB design inputs
    [AX615D_VI输入接口场景_V0.6.xlsx]
